osafune/ulexite/pcb/ulexite_parts_v1.0.pdf

ページ 1

種別 | 型　　番 | 発注品番 | 単価 | 数 | 価格 | 備　考
IC | FAN5333BSX | FAN5333BSXCT-ND | Digi-key (http://search.digikey.jp/scripts/DkSearch/dksus.dll?Detail?name=FAN5333BSXCT-ND) | 77.72 | 1 | 77.72 | 25pcs
| BU9480F-E2 | BU9480F-E2CT-ND | Digi-key (http://search.digikey.jp/scripts/DkSearch/dksus.dll?Detail?name=BU9480F-E2CT-ND) | 321.44 | 1 | 321.44 | 25pcs
D | BAT54-7-F | BAT54-FDICT-ND | Digi-key (http://search.digikey.jp/scripts/DkSearch/dksus.dll?Detail?name=BAT54-FDICT-ND) | 13.96 | 1 | 13.96 | 25pcs
RM | CRA06S0834K70JTA | CRA6S84.7KCT-ND | Digi-key (http://search.digikey.jp/scripts/DkSearch/dksus.dll?Detail?name=CRA6S84.7KCT-ND) | 9.60 | 1 | 9.60 | 10pcs
R | 15Ω (±1%, 1/16W, 1608メトリック) | RMCF0603FT15R0CT-ND | Digi-key (http://search.digikey.jp/scripts/DkSearch/dksus.dll?Detail?name=RMCF0603FT15R0CT-ND) | 2.60 | 1 | 2.60 | 10pcs
| 15kΩ (1/16W, 1608メトリック) | RMCF0603JT15K0CT-ND | Digi-key (http://search.digikey.jp/scripts/DkSearch/dksus.dll?Detail?name=RMCF0603JT15K0CT-ND) | 1.80 | 1 | 1.80 | 10pcs
| 20kΩ (1/16W, 1608メトリック) | RMCF0603JT20K0CT-ND | Digi-key (http://search.digikey.jp/scripts/DkSearch/dksus.dll?Detail?name=RMCF0603JT20K0CT-ND) | 1.80 | 1 | 1.80 | 10pcs
L | 10uH/1.4A (5020メトリック) | 587-2409-1-ND | Digi-key (http://search.digikey.jp/scripts/DkSearch/dksus.dll?Detail?name=587-2409-1-ND) | 37.20 | 1 | 37.20 | 10pcs
C | 0.1uF/50V (Y5V, 1608メトリック) | 311-1343-1-ND | Digi-key (http://search.digikey.jp/scripts/DkSearch/dksus.dll?Detail?name=311-1343-1-ND) | 0.79 | 3 | 2.37 | 100pcs
| 0.47uF/50V (Y5V, 1608メトリック) | 445-7465-1-ND | Digi-key (http://search.digikey.jp/scripts/DkSearch/dksus.dll?Detail?name=445-7465-1-ND) | 12.80 | 1 | 12.80 | 10pcs
| 10uF/10V (Y5V, 2012メトリック) | 311-1355-1-ND | Digi-key (http://search.digikey.jp/scripts/DkSearch/dksus.dll?Detail?name=311-1355-1-ND) | 8.52 | 1 | 8.52 | 25pcs
| 10uF/16V (アルミ電解, φ4) | 338-1794-1-ND | Digi-key (http://search.digikey.jp/scripts/DkSearch/dksus.dll?Detail?name=338-1794-1-ND) | 11.42 | 3 | 34.26 | 10pcs
CON | NPPC051KFXC-RC | S5636-ND | Digi-key (http://search.digikey.jp/scripts/DkSearch/dksus.dll?Detail?name=S5636-ND) | 77.80 | 1 | 77.80 | 25pcs
| NPPC202KFMS-RC | S5729-ND | Digi-key (http://search.digikey.jp/scripts/DkSearch/dksus.dll?Detail?name=S5729-ND) | 325.72 | 1 | 325.72 | 25pcs
| SJ1-3523N | CP1-3523N-ND | Digi-key (http://search.digikey.jp/scripts/DkSearch/dksus.dll?Detail?name=CP1-3523N-ND) | 60.80 | 1 | 60.80 | 10pcs
| XF2M-4015-1A | OR729CT-ND | Digi-key (http://search.digikey.jp/scripts/DkSearch/dksus.dll?Detail?name=OR729CT-ND) | 201.72 | 1 | 201.72 | 25pcs
LCD | ATM0430D5 | P-05285 | 秋月 (http://akizukidenshi.com/catalog/g/gP-05285/) | 3,000.00 | 1 | 3,000.00 | FG040346DSSWBG03で代用可
PCB | ULEXITE PCB | | | 1,890.00 | 1 | 1,890.00 | P板.com、20セット販売時単価
U | ULEXITEアクリルトップ | | | 400.00 | 1 | 400.00 | アクリルパネル加工費含む
| M3X18六角スペーサ | BSB-318CE | | 60.00 | 4 | 240.00
| PPストラックケース２６７６ | P-05475 | 秋月 (http://akizukidenshi.com/catalog/g/gP-05475/) | 90.00 | 1 | 90.00 | 10pcs
| 実装費 | | | 1,050.00 | 1 | 1,050.00 | P板.com、15枚実装時単価
| その他雑費 | | | 1,000.00 | 1 | 1,000.00

以下、余白

計 ￥8,860 | 少数以下切り捨て
税 ￥443 | 消費税５％、少数以下切捨て
合計 ￥9,303
ULEXITE部品価格表 (Rev1.0a) | ※価格は2013年7月4日現在 最新価格については各サイト参照

ページ 2

部品番号 | 数 | 型番または仕様 | 備　考
C1 | 1 | 10uF/10V (積層セラミック, 2012メトリック) | Y5V特性以上
C2,C5,C9 | 3 | 0.1uF/50V (積層セラミック, 1608メトリック) | Y5V特性以上
C3 | 1 | 0.47uF/50V (積層セラミック, 1608メトリック) | Y5V特性以上
C4,C6-8 | 3 | 10uF/16V (アルミ電解, φ4) | C4は未実装
CN1 | 1 | NPPC202KFMS
CN2 | 1 | NPPC051KFXC | NPPC051KFXDでも可
CN3 | 1 | SJ1-3523N
CN4 | 1 | XF2M-4015-1A | ハンダ面実装
D1 | 1 | BAT54-7-F
IC1 | 1 | FAN5333BSX
IC2 | 1 | BU9480F
L1 | 1 | 10uH/1.4A (5020メトリック)
R1 | 1 | 15kΩ (±5%, 1/16W, 1608メトリック)
R2 | 1 | 20kΩ (±5%, 1/16W, 1608メトリック)
R3 | 1 | 15Ω (±1%, 1/16W, 1608メトリック)
RM1 | 1 | 4.7kΩ (±5%, 1/16W, 独立4連, 3216凸端子)

以下余白

ULEXITE実装部品表 | 2013年7月4日 Rev1.0a
