osafune/ulexite/pcb/ulexite_panel.dxf

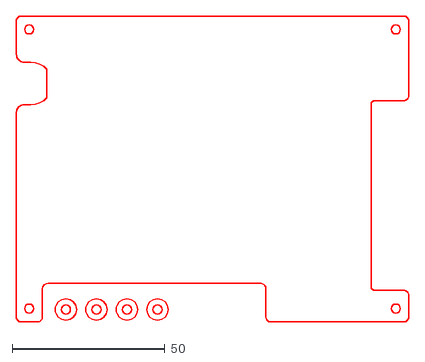
[picture p3: CAD file, 2013-12-19]
pcb/ulexite_panel.dxf
128.4 x 100.1
