osafune/ulexite/pcb/ulexite_pcb_v1.0.pdf

L

C

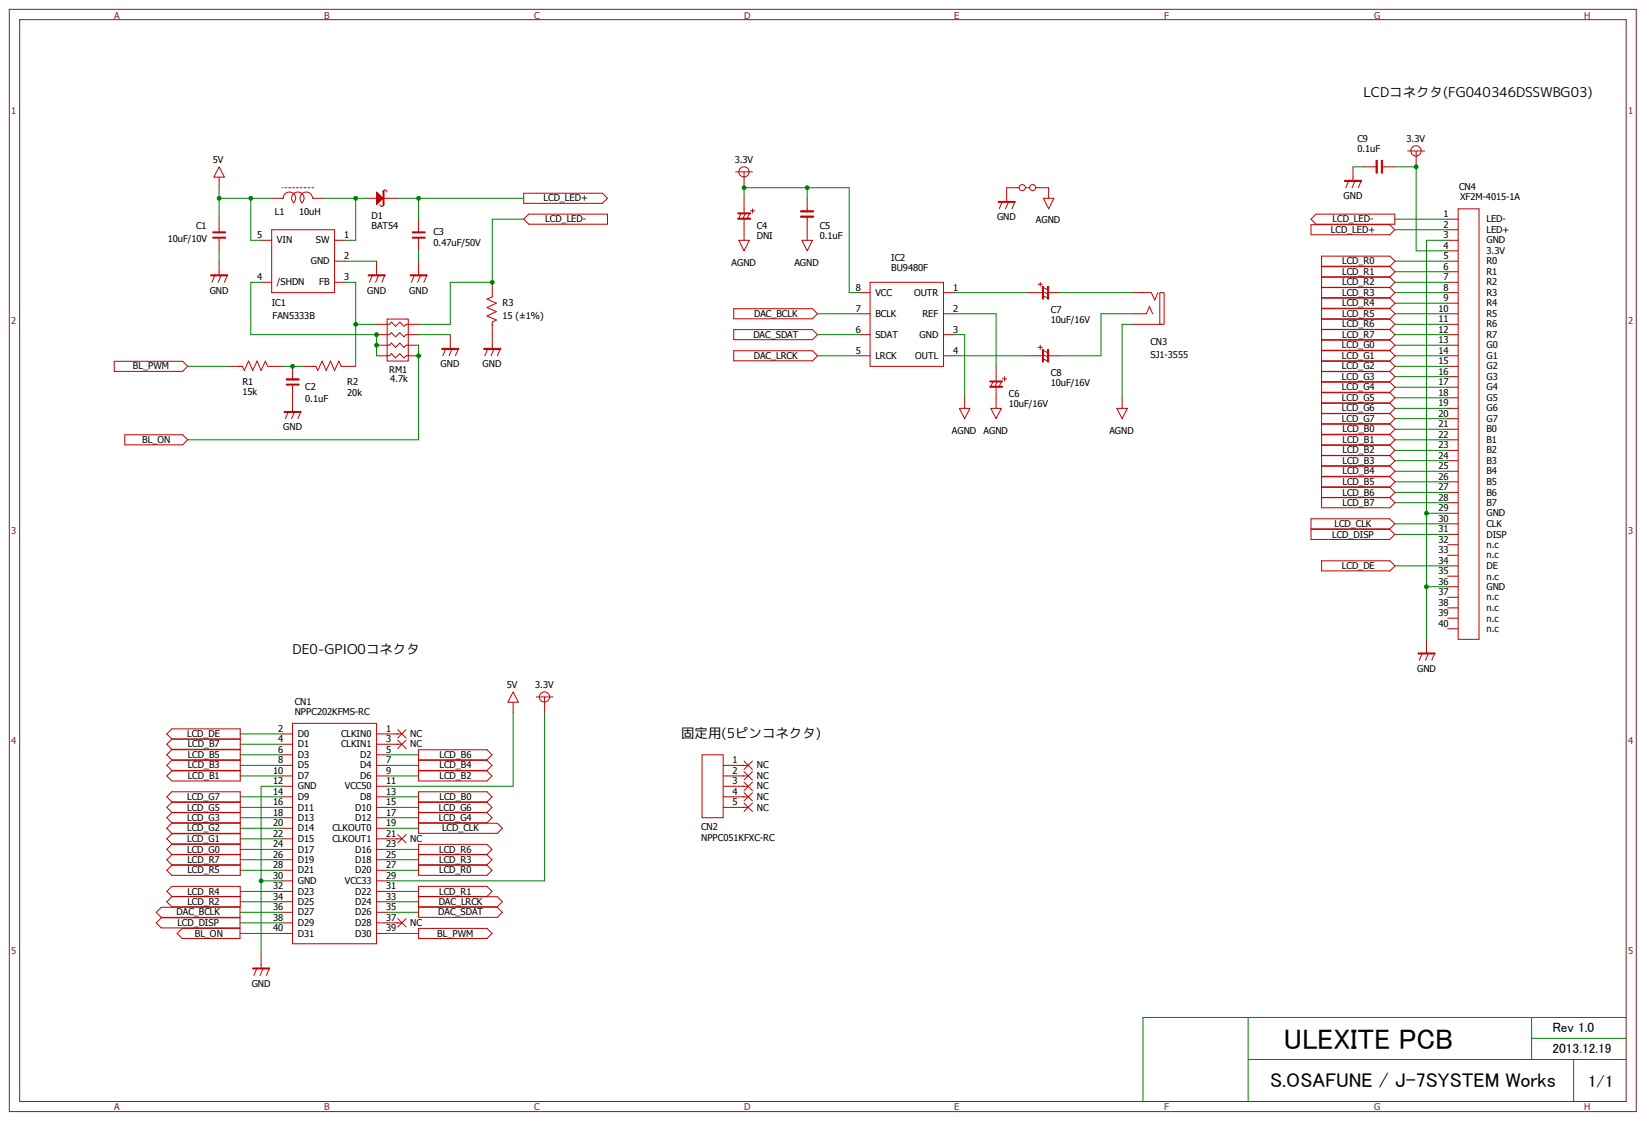
[picture p6: page 1]
PIO

L C D _ G 3 | 1 6
L C D _ G 4 | 1 8
L C D _ G 5 | 1 9
L C D _ G 7 | 2 0
L C D _ B 0 | 2 2

L C D _ B 1 | 2 3
L C D _ B 3 | 2 4
L C D _ B 4 | 2 6
L C D _ B 5 | 2 7
L C D _ B 7 | 2 8

1 6 | 1 5
1 8 | 1 7
2 0 | 1 9
2 2 | N | L C D _ C L K

2 4
2 6 | 2 5
2 8 | 2 7
3 0 | 2 9
3 2 | 3 1 L C D _ R 1
3 4 | 3 3
3 6 | 3 5 | D A C_ L R C K
3 8 | N | D A C_ S D AT
4 0
