osafune/ulexite/(list of files, drawings)

Other design files:
pcb/ulexite_pcb.pcb
