osafune/ulexite/de0_sample/cineraria_ulexite/cineraria_core/synthesis/submodules/fpoint_hw_qsys.v

// Copyright (C) 1991-2010 Altera Corporation
//  Your use of Altera Corporation's design tools, logic functions 
//  and other software and tools, and its AMPP partner logic 
//  functions, and any output files from any of the foregoing 
//  (including device programming or simulation files), and any 
//  associated documentation or information are expressly subject 
//  to the terms and conditions of the Altera Program License 
//  Subscription Agreement, Altera MegaCore Function License 
//  Agreement, or other applicable license agreement, including, 
//  without limitation, that your use is for the sole purpose of 
//  programming logic devices manufactured by Altera and sold by 
//  Altera or its authorized distributors.  Please refer to the 
//  applicable agreement for further details.



//synthesis_resources = lpm_add_sub 4 lpm_mult 1 reg 254 
//synopsys translate_off
`timescale 1 ps / 1 ps
//synopsys translate_on
module  fpoint_hw_qsys_mult_single
	( 
	aclr,
	clk_en,
	clock,
	dataa,
	datab,
	result) /* synthesis synthesis_clearbox=1 */;
	input   aclr;
	input   clk_en;
	input   clock;
	input   [31:0]  dataa;
	input   [31:0]  datab;
	output   [31:0]  result;
`ifndef ALTERA_RESERVED_QIS
// synopsys translate_off
`endif
	tri0   aclr;
	tri1   clk_en;
`ifndef ALTERA_RESERVED_QIS
// synopsys translate_on
`endif

	reg	dataa_exp_all_one_ff_p1;
	reg	dataa_exp_not_zero_ff_p1;
	reg	dataa_man_not_zero_ff_p1;
	reg	dataa_man_not_zero_ff_p2;
	reg	datab_exp_all_one_ff_p1;
	reg	datab_exp_not_zero_ff_p1;
	reg	datab_man_not_zero_ff_p1;
	reg	datab_man_not_zero_ff_p2;
	reg	[9:0]	delay_exp2_bias;
	reg	[9:0]	delay_exp3_bias;
	reg	[9:0]	delay_exp_bias;
	reg	delay_man_product_msb;
	reg	delay_man_product_msb2;
	reg	delay_man_product_msb_p0;
	reg	[23:0]	delay_round;
	reg	[8:0]	exp_add_p1;
	reg	[9:0]	exp_adj_p1;
	reg	[9:0]	exp_adj_p2;
	reg	[8:0]	exp_bias_p1;
	reg	[8:0]	exp_bias_p2;
	reg	[7:0]	exp_result_ff;
	reg	input_is_infinity_dffe_0;
	reg	input_is_infinity_dffe_1;
	reg	input_is_infinity_dffe_2;
	reg	input_is_infinity_dffe_3;
	reg	input_is_infinity_ff1;
	reg	input_is_infinity_ff2;
	reg	input_is_infinity_ff3;
	reg	input_is_infinity_ff4;
	reg	input_is_nan_dffe_0;
	reg	input_is_nan_dffe_1;
	reg	input_is_nan_dffe_2;
	reg	input_is_nan_dffe_3;
	reg	input_is_nan_ff1;
	reg	input_is_nan_ff2;
	reg	input_is_nan_ff3;
	reg	input_is_nan_ff4;
	reg	input_not_zero_dffe_0;
	reg	input_not_zero_dffe_1;
	reg	input_not_zero_dffe_2;
	reg	input_not_zero_dffe_3;
	reg	input_not_zero_ff1;
	reg	input_not_zero_ff2;
	reg	input_not_zero_ff3;
	reg	input_not_zero_ff4;
	reg	lsb_dffe;
	reg	[22:0]	man_result_ff;
	reg	man_round_carry_p0;
	reg	[23:0]	man_round_p;
	reg	[23:0]	man_round_p0;
	reg	[24:0]	man_round_p2;
	reg	round_dffe;
	reg	[0:0]	sign_node_ff0;
	reg	[0:0]	sign_node_ff1;
	reg	[0:0]	sign_node_ff2;
	reg	[0:0]	sign_node_ff3;
	reg	[0:0]	sign_node_ff4;
	reg	[0:0]	sign_node_ff5;
	reg	[0:0]	sign_node_ff6;
	reg	[0:0]	sign_node_ff7;
	reg	[0:0]	sign_node_ff8;
	reg	[0:0]	sign_node_ff9;
	reg	sticky_dffe;
	wire  [8:0]   wire_exp_add_adder_result;
	wire  [9:0]   wire_exp_adj_adder_result;
	wire  [9:0]   wire_exp_bias_subtr_result;
	wire  [24:0]   wire_man_round_adder_result;
	wire  [47:0]   wire_man_product2_mult_result;
	wire  [9:0]  bias;
	wire  [7:0]  dataa_exp_all_one;
	wire  [7:0]  dataa_exp_not_zero;
	wire  [22:0]  dataa_man_not_zero;
	wire  [7:0]  datab_exp_all_one;
	wire  [7:0]  datab_exp_not_zero;
	wire  [22:0]  datab_man_not_zero;
	wire  exp_is_inf;
	wire  exp_is_zero;
	wire  [9:0]  expmod;
	wire  [7:0]  inf_num;
	wire  lsb_bit;
	wire  [24:0]  man_shift_full;
	wire  [7:0]  result_exp_all_one;
	wire  [8:0]  result_exp_not_zero;
	wire  round_bit;
	wire  round_carry;
	wire  [22:0]  sticky_bit;

	// synopsys translate_off
	initial
		dataa_exp_all_one_ff_p1 = 0;
	// synopsys translate_on
	always @ ( posedge clock or  posedge aclr)
		if (aclr == 1'b1) dataa_exp_all_one_ff_p1 <= 1'b0;
		else if  (clk_en == 1'b1)   dataa_exp_all_one_ff_p1 <= dataa_exp_all_one[7];
	// synopsys translate_off
	initial
		dataa_exp_not_zero_ff_p1 = 0;
	// synopsys translate_on
	always @ ( posedge clock or  posedge aclr)
		if (aclr == 1'b1) dataa_exp_not_zero_ff_p1 <= 1'b0;
		else if  (clk_en == 1'b1)   dataa_exp_not_zero_ff_p1 <= dataa_exp_not_zero[7];
	// synopsys translate_off
	initial
		dataa_man_not_zero_ff_p1 = 0;
	// synopsys translate_on
	always @ ( posedge clock or  posedge aclr)
		if (aclr == 1'b1) dataa_man_not_zero_ff_p1 <= 1'b0;
		else if  (clk_en == 1'b1)   dataa_man_not_zero_ff_p1 <= dataa_man_not_zero[10];
	// synopsys translate_off
	initial
		dataa_man_not_zero_ff_p2 = 0;
	// synopsys translate_on
	always @ ( posedge clock or  posedge aclr)
		if (aclr == 1'b1) dataa_man_not_zero_ff_p2 <= 1'b0;
		else if  (clk_en == 1'b1)   dataa_man_not_zero_ff_p2 <= dataa_man_not_zero[22];
	// synopsys translate_off
	initial
		datab_exp_all_one_ff_p1 = 0;
	// synopsys translate_on
	always @ ( posedge clock or  posedge aclr)
		if (aclr == 1'b1) datab_exp_all_one_ff_p1 <= 1'b0;
		else if  (clk_en == 1'b1)   datab_exp_all_one_ff_p1 <= datab_exp_all_one[7];
	// synopsys translate_off
	initial
		datab_exp_not_zero_ff_p1 = 0;
	// synopsys translate_on
	always @ ( posedge clock or  posedge aclr)
		if (aclr == 1'b1) datab_exp_not_zero_ff_p1 <= 1'b0;
		else if  (clk_en == 1'b1)   datab_exp_not_zero_ff_p1 <= datab_exp_not_zero[7];
	// synopsys translate_off
	initial
		datab_man_not_zero_ff_p1 = 0;
	// synopsys translate_on
	always @ ( posedge clock or  posedge aclr)
		if (aclr == 1'b1) datab_man_not_zero_ff_p1 <= 1'b0;
		else if  (clk_en == 1'b1)   datab_man_not_zero_ff_p1 <= datab_man_not_zero[10];
	// synopsys translate_off
	initial
		datab_man_not_zero_ff_p2 = 0;
	// synopsys translate_on
	always @ ( posedge clock or  posedge aclr)
		if (aclr == 1'b1) datab_man_not_zero_ff_p2 <= 1'b0;
		else if  (clk_en == 1'b1)   datab_man_not_zero_ff_p2 <= datab_man_not_zero[22];
	// synopsys translate_off
	initial
		delay_exp2_bias = 0;
	// synopsys translate_on
	always @ ( posedge clock or  posedge aclr)
		if (aclr == 1'b1) delay_exp2_bias <= 10'b0;
		else if  (clk_en == 1'b1)   delay_exp2_bias <= delay_exp_bias;
	// synopsys translate_off
	initial
		delay_exp3_bias = 0;
	// synopsys translate_on
	always @ ( posedge clock or  posedge aclr)
		if (aclr == 1'b1) delay_exp3_bias <= 10'b0;
		else if  (clk_en == 1'b1)   delay_exp3_bias <= delay_exp2_bias;
	// synopsys translate_off
	initial
		delay_exp_bias = 0;
	// synopsys translate_on
	always @ ( posedge clock or  posedge aclr)
		if (aclr == 1'b1) delay_exp_bias <= 10'b0;
		else if  (clk_en == 1'b1)   delay_exp_bias <= wire_exp_bias_subtr_result;
	// synopsys translate_off
	initial
		delay_man_product_msb = 0;
	// synopsys translate_on
	always @ ( posedge clock or  posedge aclr)
		if (aclr == 1'b1) delay_man_product_msb <= 1'b0;
		else if  (clk_en == 1'b1)   delay_man_product_msb <= delay_man_product_msb_p0;
	// synopsys translate_off
	initial
		delay_man_product_msb2 = 0;
	// synopsys translate_on
	always @ ( posedge clock or  posedge aclr)
		if (aclr == 1'b1) delay_man_product_msb2 <= 1'b0;
		else if  (clk_en == 1'b1)   delay_man_product_msb2 <= delay_man_product_msb;
	// synopsys translate_off
	initial
		delay_man_product_msb_p0 = 0;
	// synopsys translate_on
	always @ ( posedge clock or  posedge aclr)
		if (aclr == 1'b1) delay_man_product_msb_p0 <= 1'b0;
		else if  (clk_en == 1'b1)   delay_man_product_msb_p0 <= wire_man_product2_mult_result[47];
	// synopsys translate_off
	initial
		delay_round = 0;
	// synopsys translate_on
	always @ ( posedge clock or  posedge aclr)
		if (aclr == 1'b1) delay_round <= 24'b0;
		else if  (clk_en == 1'b1)   delay_round <= ((man_round_p2[23:0] & {24{(~ man_round_p2[24])}}) | (man_round_p2[24:1] & {24{man_round_p2[24]}}));
	// synopsys translate_off
	initial
		exp_add_p1 = 0;
	// synopsys translate_on
	always @ ( posedge clock or  posedge aclr)
		if (aclr == 1'b1) exp_add_p1 <= 9'b0;
		else if  (clk_en == 1'b1)   exp_add_p1 <= wire_exp_add_adder_result;
	// synopsys translate_off
	initial
		exp_adj_p1 = 0;
	// synopsys translate_on
	always @ ( posedge clock or  posedge aclr)
		if (aclr == 1'b1) exp_adj_p1 <= 10'b0;
		else if  (clk_en == 1'b1)   exp_adj_p1 <= delay_exp3_bias;
	// synopsys translate_off
	initial
		exp_adj_p2 = 0;
	// synopsys translate_on
	always @ ( posedge clock or  posedge aclr)
		if (aclr == 1'b1) exp_adj_p2 <= 10'b0;
		else if  (clk_en == 1'b1)   exp_adj_p2 <= wire_exp_adj_adder_result;
	// synopsys translate_off
	initial
		exp_bias_p1 = 0;
	// synopsys translate_on
	always @ ( posedge clock or  posedge aclr)
		if (aclr == 1'b1) exp_bias_p1 <= 9'b0;
		else if  (clk_en == 1'b1)   exp_bias_p1 <= exp_add_p1[8:0];
	// synopsys translate_off
	initial
		exp_bias_p2 = 0;
	// synopsys translate_on
	always @ ( posedge clock or  posedge aclr)
		if (aclr == 1'b1) exp_bias_p2 <= 9'b0;
		else if  (clk_en == 1'b1)   exp_bias_p2 <= exp_bias_p1;
	// synopsys translate_off
	initial
		exp_result_ff = 0;
	// synopsys translate_on
	always @ ( posedge clock or  posedge aclr)
		if (aclr == 1'b1) exp_result_ff <= 8'b0;
		else if  (clk_en == 1'b1)   exp_result_ff <= ((inf_num & {8{((exp_is_inf | input_is_infinity_ff4) | input_is_nan_ff4)}}) | ((exp_adj_p2[7:0] & {8{(~ exp_is_zero)}}) & {8{input_not_zero_ff4}}));
	// synopsys translate_off
	initial
		input_is_infinity_dffe_0 = 0;
	// synopsys translate_on
	always @ ( posedge clock or  posedge aclr)
		if (aclr == 1'b1) input_is_infinity_dffe_0 <= 1'b0;
		else if  (clk_en == 1'b1)   input_is_infinity_dffe_0 <= ((dataa_exp_all_one_ff_p1 & (~ (dataa_man_not_zero_ff_p1 | dataa_man_not_zero_ff_p2))) | (datab_exp_all_one_ff_p1 & (~ (datab_man_not_zero_ff_p1 | datab_man_not_zero_ff_p2))));
	// synopsys translate_off
	initial
		input_is_infinity_dffe_1 = 0;
	// synopsys translate_on
	always @ ( posedge clock or  posedge aclr)
		if (aclr == 1'b1) input_is_infinity_dffe_1 <= 1'b0;
		else if  (clk_en == 1'b1)   input_is_infinity_dffe_1 <= input_is_infinity_dffe_0;
	// synopsys translate_off
	initial
		input_is_infinity_dffe_2 = 0;
	// synopsys translate_on
	always @ ( posedge clock or  posedge aclr)
		if (aclr == 1'b1) input_is_infinity_dffe_2 <= 1'b0;
		else if  (clk_en == 1'b1)   input_is_infinity_dffe_2 <= input_is_infinity_dffe_1;
	// synopsys translate_off
	initial
		input_is_infinity_dffe_3 = 0;
	// synopsys translate_on
	always @ ( posedge clock or  posedge aclr)
		if (aclr == 1'b1) input_is_infinity_dffe_3 <= 1'b0;
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
		else if  (clk_en == 1'b1)   input_not_zero_dffe_2 <= input_not_zero_dffe_1;
	// synopsys translate_off
	initial
		input_not_zero_dffe_3 = 0;
	// synopsys translate_on
	always @ ( posedge clock or  posedge aclr)
		if (aclr == 1'b1) input_not_zero_dffe_3 <= 1'b0;
		else if  (clk_en == 1'b1)   input_not_zero_dffe_3 <= input_not_zero_dffe_2;
	// synopsys translate_off
	initial
		input_not_zero_ff1 = 0;
	// synopsys translate_on
	always @ ( posedge clock or  posedge aclr)
		if (aclr == 1'b1) input_not_zero_ff1 <= 1'b0;
		else if  (clk_en == 1'b1)   input_not_zero_ff1 <= input_not_zero_dffe_3;
	// synopsys translate_off
	initial
		input_not_zero_ff2 = 0;
	// synopsys translate_on
	always @ ( posedge clock or  posedge aclr)
		if (aclr == 1'b1) input_not_zero_ff2 <= 1'b0;
		else if  (clk_en == 1'b1)   input_not_zero_ff2 <= input_not_zero_ff1;
	// synopsys translate_off
	initial
		input_not_zero_ff3 = 0;
	// synopsys translate_on
	always @ ( posedge clock or  posedge aclr)
		if (aclr == 1'b1) input_not_zero_ff3 <= 1'b0;
		else if  (clk_en == 1'b1)   input_not_zero_ff3 <= input_not_zero_ff2;
	// synopsys translate_off
	initial
		input_not_zero_ff4 = 0;
	// synopsys translate_on
	always @ ( posedge clock or  posedge aclr)
		if (aclr == 1'b1) input_not_zero_ff4 <= 1'b0;
		else if  (clk_en == 1'b1)   input_not_zero_ff4 <= input_not_zero_ff3;
	// synopsys translate_off
	initial
		lsb_dffe = 0;
	// synopsys translate_on
	always @ ( posedge clock or  posedge aclr)
		if (aclr == 1'b1) lsb_dffe <= 1'b0;
		else if  (clk_en == 1'b1)   lsb_dffe <= lsb_bit;
	// synopsys translate_off
	initial
		man_result_ff = 0;
	// synopsys translate_on
	always @ ( posedge clock or  posedge aclr)
		if (aclr == 1'b1) man_result_ff <= 23'b0;
		else if  (clk_en == 1'b1)   man_result_ff <= {((((((delay_round[22] & input_not_zero_ff4) & (~ input_is_infinity_ff4)) & (~ exp_is_inf)) & (~ exp_is_zero)) | (input_is_infinity_ff4 & (~ input_not_zero_ff4))) | input_is_nan_ff4), (((((delay_round[21:0] & {22{input_not_zero_ff4}}) & {22{(~ input_is_infinity_ff4)}}) & {22{(~ exp_is_inf)}}) & {22{(~ exp_is_zero)}}) & {22{(~ input_is_nan_ff4)}})};
	// synopsys translate_off
	initial
		man_round_carry_p0 = 0;
	// synopsys translate_on
	always @ ( posedge clock or  posedge aclr)
		if (aclr == 1'b1) man_round_carry_p0 <= 1'b0;
		else if  (clk_en == 1'b1)   man_round_carry_p0 <= round_carry;
	// synopsys translate_off
	initial
		man_round_p = 0;
	// synopsys translate_on
	always @ ( posedge clock or  posedge aclr)
		if (aclr == 1'b1) man_round_p <= 24'b0;
		else if  (clk_en == 1'b1)   man_round_p <= man_shift_full[24:1];
	// synopsys translate_off
	initial
		man_round_p0 = 0;
	// synopsys translate_on
	always @ ( posedge clock or  posedge aclr)
		if (aclr == 1'b1) man_round_p0 <= 24'b0;
		else if  (clk_en == 1'b1)   man_round_p0 <= man_round_p;
	// synopsys translate_off
	initial
		man_round_p2 = 0;
	// synopsys translate_on
	always @ ( posedge clock or  posedge aclr)
		if (aclr == 1'b1) man_round_p2 <= 25'b0;
		else if  (clk_en == 1'b1)   man_round_p2 <= wire_man_round_adder_result;
	// synopsys translate_off
	initial
		round_dffe = 0;
	// synopsys translate_on
	always @ ( posedge clock or  posedge aclr)
		if (aclr == 1'b1) round_dffe <= 1'b0;
		else if  (clk_en == 1'b1)   round_dffe <= round_bit;
	// synopsys translate_off
	initial
		sign_node_ff0 = 0;
	// synopsys translate_on
	always @ ( posedge clock or  posedge aclr)
		if (aclr == 1'b1) sign_node_ff0 <= 1'b0;
		else if  (clk_en == 1'b1)   sign_node_ff0 <= (dataa[31] ^ datab[31]);
	// synopsys translate_off
	initial
		sign_node_ff1 = 0;
	// synopsys translate_on
	always @ ( posedge clock or  posedge aclr)
		if (aclr == 1'b1) sign_node_ff1 <= 1'b0;
		else if  (clk_en == 1'b1)   sign_node_ff1 <= sign_node_ff0[0:0];
	// synopsys translate_off
	initial
		sign_node_ff2 = 0;
	// synopsys translate_on
	always @ ( posedge clock or  posedge aclr)
		if (aclr == 1'b1) sign_node_ff2 <= 1'b0;
		else if  (clk_en == 1'b1)   sign_node_ff2 <= sign_node_ff1[0:0];
	// synopsys translate_off
	initial
		sign_node_ff3 = 0;
	// synopsys translate_on
	always @ ( posedge clock or  posedge aclr)
		if (aclr == 1'b1) sign_node_ff3 <= 1'b0;
		else if  (clk_en == 1'b1)   sign_node_ff3 <= sign_node_ff2[0:0];
	// synopsys translate_off
	initial
		sign_node_ff4 = 0;
	// synopsys translate_on
	always @ ( posedge clock or  posedge aclr)
		if (aclr == 1'b1) sign_node_ff4 <= 1'b0;
		else if  (clk_en == 1'b1)   sign_node_ff4 <= sign_node_ff3[0:0];
	// synopsys translate_off
	initial
		sign_node_ff5 = 0;
	// synopsys translate_on
	always @ ( posedge clock or  posedge aclr)
		if (aclr == 1'b1) sign_node_ff5 <= 1'b0;
		else if  (clk_en == 1'b1)   sign_node_ff5 <= sign_node_ff4[0:0];
	// synopsys translate_off
	initial
		sign_node_ff6 = 0;
	// synopsys translate_on
	always @ ( posedge clock or  posedge aclr)
		if (aclr == 1'b1) sign_node_ff6 <= 1'b0;
		else if  (clk_en == 1'b1)   sign_node_ff6 <= sign_node_ff5[0:0];
	// synopsys translate_off
	initial
		sign_node_ff7 = 0;
	// synopsys translate_on
	always @ ( posedge clock or  posedge aclr)
		if (aclr == 1'b1) sign_node_ff7 <= 1'b0;
		else if  (clk_en == 1'b1)   sign_node_ff7 <= sign_node_ff6[0:0];
	// synopsys translate_off
	initial
		sign_node_ff8 = 0;
	// synopsys translate_on
	always @ ( posedge clock or  posedge aclr)
		if (aclr == 1'b1) sign_node_ff8 <= 1'b0;
		else if  (clk_en == 1'b1)   sign_node_ff8 <= sign_node_ff7[0:0];
	// synopsys translate_off
	initial
		sign_node_ff9 = 0;
	// synopsys translate_on
	always @ ( posedge clock or  posedge aclr)
		if (aclr == 1'b1) sign_node_ff9 <= 1'b0;
		else if  (clk_en == 1'b1)   sign_node_ff9 <= sign_node_ff8[0:0];
	// synopsys translate_off
	initial
		sticky_dffe = 0;
	// synopsys translate_on
	always @ ( posedge clock or  posedge aclr)
		if (aclr == 1'b1) sticky_dffe <= 1'b0;
		else if  (clk_en == 1'b1)   sticky_dffe <= sticky_bit[22];
	lpm_add_sub   exp_add_adder
	( 
	.aclr(aclr),
	.cin(1'b0),
	.clken(clk_en),
	.clock(clock),
	.cout(),
	.dataa({1'b0, dataa[30:23]}),
	.datab({1'b0, datab[30:23]}),
	.overflow(),
	.result(wire_exp_add_adder_result)
	`ifndef FORMAL_VERIFICATION
	// synopsys translate_off
	`endif
	,
	.add_sub(1'b1)
	`ifndef FORMAL_VERIFICATION
	// synopsys translate_on
	`endif
	);
	defparam
		exp_add_adder.lpm_pipeline = 1,
		exp_add_adder.lpm_width = 9,
		exp_add_adder.lpm_type = "lpm_add_sub";
	lpm_add_sub   exp_adj_adder
	( 
	.cin(1'b0),
	.cout(),
	.dataa(exp_adj_p1),
	.datab({expmod[9:0]}),
	.overflow(),
	.result(wire_exp_adj_adder_result)
	`ifndef FORMAL_VERIFICATION
	// synopsys translate_off
	`endif
	,
	.aclr(1'b0),
	.add_sub(1'b1),
	.clken(1'b1),
	.clock(1'b0)
	`ifndef FORMAL_VERIFICATION
	// synopsys translate_on
	`endif
	);
	defparam
		exp_adj_adder.lpm_pipeline = 0,
		exp_adj_adder.lpm_width = 10,
		exp_adj_adder.lpm_type = "lpm_add_sub";
	lpm_add_sub   exp_bias_subtr
	( 
	.cout(),
	.dataa({1'b0, exp_bias_p2}),
	.datab({bias[9:0]}),
	.overflow(),
	.result(wire_exp_bias_subtr_result)
	`ifndef FORMAL_VERIFICATION
	// synopsys translate_off
	`endif
	,
	.aclr(1'b0),
	.add_sub(1'b1),
	.cin(),
	.clken(1'b1),
	.clock(1'b0)
	`ifndef FORMAL_VERIFICATION
	// synopsys translate_on
	`endif
	);
	defparam
		exp_bias_subtr.lpm_direction = "SUB",
		exp_bias_subtr.lpm_pipeline = 0,
		exp_bias_subtr.lpm_representation = "UNSIGNED",
		exp_bias_subtr.lpm_width = 10,
		exp_bias_subtr.lpm_type = "lpm_add_sub";
	lpm_add_sub   man_round_adder
	( 
	.cout(),
	.dataa({1'b0, man_round_p0}),
	.datab({{24{1'b0}}, man_round_carry_p0}),
	.overflow(),
	.result(wire_man_round_adder_result)
	`ifndef FORMAL_VERIFICATION
	// synopsys translate_off
	`endif
	,
	.aclr(1'b0),
	.add_sub(1'b1),
	.cin(),
	.clken(1'b1),
	.clock(1'b0)
	`ifndef FORMAL_VERIFICATION
	// synopsys translate_on
	`endif
	);
	defparam
		man_round_adder.lpm_pipeline = 0,
		man_round_adder.lpm_width = 25,
		man_round_adder.lpm_type = "lpm_add_sub";
	lpm_mult   man_product2_mult
	( 
	.aclr(aclr),
	.clken(clk_en),
	.clock(clock),
	.dataa({1'b1, dataa[22:0]}),
	.datab({1'b1, datab[22:0]}),
	.result(wire_man_product2_mult_result)
	`ifndef FORMAL_VERIFICATION
	// synopsys translate_off
	`endif
	,
	.sum({1{1'b0}})
	`ifndef FORMAL_VERIFICATION
	// synopsys translate_on
	`endif
	);
	defparam
		man_product2_mult.lpm_pipeline = 5,
		man_product2_mult.lpm_representation = "UNSIGNED",
		man_product2_mult.lpm_widtha = 24,
		man_product2_mult.lpm_widthb = 24,
		man_product2_mult.lpm_widthp = 48,
		man_product2_mult.lpm_widths = 1,
		man_product2_mult.lpm_type = "lpm_mult",
		man_product2_mult.lpm_hint = "DEDICATED_MULTIPLIER_CIRCUITRY=YES";
	assign
		bias = {{3{1'b0}}, {7{1'b1}}},
		dataa_exp_all_one = {(dataa[30] & dataa_exp_all_one[6]), (dataa[29] & dataa_exp_all_one[5]), (dataa[28] & dataa_exp_all_one[4]), (dataa[27] & dataa_exp_all_one[3]), (dataa[26] & dataa_exp_all_one[2]), (dataa[25] & dataa_exp_all_one[1]), (dataa[24] & dataa_exp_all_one[0]), dataa[23]},
		dataa_exp_not_zero = {(dataa[30] | dataa_exp_not_zero[6]), (dataa[29] | dataa_exp_not_zero[5]), (dataa[28] | dataa_exp_not_zero[4]), (dataa[27] | dataa_exp_not_zero[3]), (dataa[26] | dataa_exp_not_zero[2]), (dataa[25] | dataa_exp_not_zero[1]), (dataa[24] | dataa_exp_not_zero[0]), dataa[23]},
		dataa_man_not_zero = {(dataa[22] | dataa_man_not_zero[21]), (dataa[21] | dataa_man_not_zero[20]), (dataa[20] | dataa_man_not_zero[19]), (dataa[19] | dataa_man_not_zero[18]), (dataa[18] | dataa_man_not_zero[17]), (dataa[17] | dataa_man_not_zero[16]), (dataa[16] | dataa_man_not_zero[15]), (dataa[15] | dataa_man_not_zero[14]), (dataa[14] | dataa_man_not_zero[13]), (dataa[13] | dataa_man_not_zero[12]), (dataa[12] | dataa_man_not_zero[11]), dataa[11], (dataa[10] | dataa_man_not_zero[9]), (dataa[9] | dataa_man_not_zero[8]), (dataa[8] | dataa_man_not_zero[7]), (dataa[7] | dataa_man_not_zero[6]), (dataa[6] | dataa_man_not_zero[5]), (dataa[5] | dataa_man_not_zero[4]), (dataa[4] | dataa_man_not_zero[3]), (dataa[3] | dataa_man_not_zero[2]), (dataa[2] | dataa_man_not_zero[1]), (dataa[1] | dataa_man_not_zero[0]), dataa[0]},
		datab_exp_all_one = {(datab[30] & datab_exp_all_one[6]), (datab[29] & datab_exp_all_one[5]), (datab[28] & datab_exp_all_one[4]), (datab[27] & datab_exp_all_one[3]), (datab[26] & datab_exp_all_one[2]), (datab[25] & datab_exp_all_one[1]), (datab[24] & datab_exp_all_one[0]), datab[23]},
		datab_exp_not_zero = {(datab[30] | datab_exp_not_zero[6]), (datab[29] | datab_exp_not_zero[5]), (datab[28] | datab_exp_not_zero[4]), (datab[27] | datab_exp_not_zero[3]), (datab[26] | datab_exp_not_zero[2]), (datab[25] | datab_exp_not_zero[1]), (datab[24] | datab_exp_not_zero[0]), datab[23]},
		datab_man_not_zero = {(datab[22] | datab_man_not_zero[21]), (datab[21] | datab_man_not_zero[20]), (datab[20] | datab_man_not_zero[19]), (datab[19] | datab_man_not_zero[18]), (datab[18] | datab_man_not_zero[17]), (datab[17] | datab_man_not_zero[16]), (datab[16] | datab_man_not_zero[15]), (datab[15] | datab_man_not_zero[14]), (datab[14] | datab_man_not_zero[13]), (datab[13] | datab_man_not_zero[12]), (datab[12] | datab_man_not_zero[11]), datab[11], (datab[10] | datab_man_not_zero[9]), (datab[9] | datab_man_not_zero[8]), (datab[8] | datab_man_not_zero[7]), (datab[7] | datab_man_not_zero[6]), (datab[6] | datab_man_not_zero[5]), (datab[5] | datab_man_not_zero[4]), (datab[4] | datab_man_not_zero[3]), (datab[3] | datab_man_not_zero[2]), (datab[2] | datab_man_not_zero[1]), (datab[1] | datab_man_not_zero[0]), datab[0]},
		exp_is_inf = (((~ exp_adj_p2[9]) & exp_adj_p2[8]) | ((~ exp_adj_p2[8]) & result_exp_all_one[7])),
		exp_is_zero = (exp_adj_p2[9] | (~ result_exp_not_zero[8])),
		expmod = {{8{1'b0}}, (delay_man_product_msb2 & man_round_p2[24]), (delay_man_product_msb2 ^ man_round_p2[24])},
		inf_num = {8{1'b1}},
		lsb_bit = man_shift_full[1],
		man_shift_full = ((wire_man_product2_mult_result[46:22] & {25{(~ wire_man_product2_mult_result[47])}}) | (wire_man_product2_mult_result[47:23] & {25{wire_man_product2_mult_result[47]}})),
		result = {sign_node_ff9[0:0], exp_result_ff[7:0], man_result_ff[22:0]},
		result_exp_all_one = {(result_exp_all_one[6] & exp_adj_p2[7]), (result_exp_all_one[5] & exp_adj_p2[6]), (result_exp_all_one[4] & exp_adj_p2[5]), (result_exp_all_one[3] & exp_adj_p2[4]), (result_exp_all_one[2] & exp_adj_p2[3]), (result_exp_all_one[1] & exp_adj_p2[2]), (result_exp_all_one[0] & exp_adj_p2[1]), exp_adj_p2[0]},
		result_exp_not_zero = {(result_exp_not_zero[7] | exp_adj_p2[8]), (result_exp_not_zero[6] | exp_adj_p2[7]), (result_exp_not_zero[5] | exp_adj_p2[6]), (result_exp_not_zero[4] | exp_adj_p2[5]), (result_exp_not_zero[3] | exp_adj_p2[4]), (result_exp_not_zero[2] | exp_adj_p2[3]), (result_exp_not_zero[1] | exp_adj_p2[2]), (result_exp_not_zero[0] | exp_adj_p2[1]), exp_adj_p2[0]},
		round_bit = man_shift_full[0],
		round_carry = (round_dffe & (lsb_dffe | sticky_dffe)),
		sticky_bit = {(sticky_bit[21] | (wire_man_product2_mult_result[47] & wire_man_product2_mult_result[22])), (sticky_bit[20] | wire_man_product2_mult_result[21]), (sticky_bit[19] | wire_man_product2_mult_result[20]), (sticky_bit[18] | wire_man_product2_mult_result[19]), (sticky_bit[17] | wire_man_product2_mult_result[18]), (sticky_bit[16] | wire_man_product2_mult_result[17]), (sticky_bit[15] | wire_man_product2_mult_result[16]), (sticky_bit[14] | wire_man_product2_mult_result[15]), (sticky_bit[13] | wire_man_product2_mult_result[14]), (sticky_bit[12] | wire_man_product2_mult_result[13]), (sticky_bit[11] | wire_man_product2_mult_result[12]), (sticky_bit[10] | wire_man_product2_mult_result[11]), (sticky_bit[9] | wire_man_product2_mult_result[10]), (sticky_bit[8] | wire_man_product2_mult_result[9]), (sticky_bit[7] | wire_man_product2_mult_result[8]), (sticky_bit[6] | wire_man_product2_mult_result[7]), (sticky_bit[5] | wire_man_product2_mult_result[6]), (sticky_bit[4] | wire_man_product2_mult_result[5]), (sticky_bit[3] | wire_man_product2_mult_result[4]), (sticky_bit[2] | wire_man_product2_mult_result[3]), (sticky_bit[1] | wire_man_product2_mult_result[2]), (sticky_bit[0] | wire_man_product2_mult_result[1]), wire_man_product2_mult_result[0]};
endmodule //fpoint_hw_qsys_mult_single
//VALID FILE

//altfp_add_sub CBX_AUTO_BLACKBOX="ON" CBX_SINGLE_OUTPUT_FILE="ON" DENORMAL_SUPPORT="NO" DEVICE_FAMILY="STRATIXIV" DIRECTION="VARIABLE" EXCEPTION_HANDLING="NO" PIPELINE=8 REDUCED_FUNCTIONALITY="NO" SPEED_OPTIMIZED="YES" WIDTH_EXP=8 WIDTH_MAN=23 aclr add_sub clk_en clock dataa datab result
//VERSION_BEGIN 10.1 cbx_altbarrel_shift 2010:09:06:21:07:24:PN cbx_altfp_add_sub 2010:09:06:21:07:24:PN cbx_altpriority_encoder 2010:09:06:21:07:25:PN cbx_cycloneii 2010:09:06:21:07:25:PN cbx_lpm_add_sub 2010:09:06:21:07:25:PN cbx_lpm_compare 2010:09:06:21:07:25:PN cbx_mgl 2010:09:06:21:22:18:PN cbx_stratix 2010:09:06:21:07:25:PN cbx_stratixii 2010:09:06:21:07:25:PN  VERSION_END
// synthesis VERILOG_INPUT_VERSION VERILOG_2001
// altera message_off 10463



// Copyright (C) 1991-2010 Altera Corporation
//  Your use of Altera Corporation's design tools, logic functions 
//  and other software and tools, and its AMPP partner logic 
//  functions, and any output files from any of the foregoing 
//  (including device programming or simulation files), and any 
//  associated documentation or information are expressly subject 
//  to the terms and conditions of the Altera Program License 
//  Subscription Agreement, Altera MegaCore Function License 
//  Agreement, or other applicable license agreement, including, 
//  without limitation, that your use is for the sole purpose of 
//  programming logic devices manufactured by Altera and sold by 
//  Altera or its authorized distributors.  Please refer to the 
//  applicable agreement for further details.




//altbarrel_shift CBX_AUTO_BLACKBOX="ON" CBX_SINGLE_OUTPUT_FILE="ON" DEVICE_FAMILY="STRATIXIV" PIPELINE=1 SHIFTDIR="LEFT" WIDTH=26 WIDTHDIST=5 aclr clk_en clock data distance result
//VERSION_BEGIN 10.1 cbx_altbarrel_shift 2010:09:06:21:07:24:PN cbx_mgl 2010:09:06:21:22:18:PN  VERSION_END

//synthesis_resources = reg 27 
//synopsys translate_off
`timescale 1 ps / 1 ps
//synopsys translate_on
module  fpoint_hw_qsys_addsub_single_altbarrel_shift_fjg
	( 
	aclr,
	clk_en,
	clock,
	data,
	distance,
	result) /* synthesis synthesis_clearbox=1 */;
	input   aclr;
	input   clk_en;
	input   clock;
	input   [25:0]  data;
	input   [4:0]  distance;
	output   [25:0]  result;
`ifndef ALTERA_RESERVED_QIS
// synopsys translate_off
`endif
	tri0   aclr;
	tri1   clk_en;
	tri0   clock;
`ifndef ALTERA_RESERVED_QIS
// synopsys translate_on
`endif

	reg	[0:0]	dir_pipe;
	reg	[25:0]	sbit_piper1d;
	wire  [5:0]  dir_w;
	wire  direction_w;
	wire  [15:0]  pad_w;
	wire  [155:0]  sbit_w;
	wire  [4:0]  sel_w;
	wire  [129:0]  smux_w;

	// synopsys translate_off
	initial
		dir_pipe = 0;
	// synopsys translate_on
	always @ ( posedge clock or  posedge aclr)
		if (aclr == 1'b1) dir_pipe <= 1'b0;
		else if  (clk_en == 1'b1)   dir_pipe <= {dir_w[4]};
	// synopsys translate_off
	initial
		sbit_piper1d = 0;
	// synopsys translate_on
	always @ ( posedge clock or  posedge aclr)
		if (aclr == 1'b1) sbit_piper1d <= 26'b0;
		else if  (clk_en == 1'b1)   sbit_piper1d <= smux_w[129:104];
	assign
		dir_w = {dir_pipe[0], dir_w[3:0], direction_w},
		direction_w = 1'b0,
		pad_w = {16{1'b0}},
		result = sbit_w[155:130],
		sbit_w = {sbit_piper1d, smux_w[103:0], data},
		sel_w = {distance[4:0]},
		smux_w = {((({26{(sel_w[4] & (~ dir_w[4]))}} & {sbit_w[113:104], pad_w[15:0]}) | ({26{(sel_w[4] & dir_w[4])}} & {pad_w[15:0], sbit_w[129:120]})) | ({26{(~ sel_w[4])}} & sbit_w[129:104])), ((({26{(sel_w[3] & (~ dir_w[3]))}} & {sbit_w[95:78], pad_w[7:0]}) | ({26{(sel_w[3] & dir_w[3])}} & {pad_w[7:0], sbit_w[103:86]})) | ({26{(~ sel_w[3])}} & sbit_w[103:78])), ((({26{(sel_w[2] & (~ dir_w[2]))}} & {sbit_w[73:52], pad_w[3:0]}) | ({26{(sel_w[2] & dir_w[2])}} & {pad_w[3:0], sbit_w[77:56]})) | ({26{(~ sel_w[2])}} & sbit_w[77:52])), ((({26{(sel_w[1] & (~ dir_w[1]))}} & {sbit_w[49:26], pad_w[1:0]}) | ({26{(sel_w[1] & dir_w[1])}} & {pad_w[1:0], sbit_w[51:28]})) | ({26{(~ sel_w[1])}} & sbit_w[51:26])), ((({26{(sel_w[0] & (~ dir_w[0]))}} & {sbit_w[24:0], pad_w[0]}) | ({26{(sel_w[0] & dir_w[0])}} & {pad_w[0], sbit_w[25:1]})) | ({26{(~ sel_w[0])}} & sbit_w[25:0]))};
endmodule //fpoint_hw_qsys_addsub_single_altbarrel_shift_fjg


//altbarrel_shift CBX_AUTO_BLACKBOX="ON" CBX_SINGLE_OUTPUT_FILE="ON" DEVICE_FAMILY="STRATIXIV" SHIFTDIR="RIGHT" WIDTH=26 WIDTHDIST=5 data distance result
//VERSION_BEGIN 10.1 cbx_altbarrel_shift 2010:09:06:21:07:24:PN cbx_mgl 2010:09:06:21:22:18:PN  VERSION_END

//synthesis_resources = 
//synopsys translate_off
`timescale 1 ps / 1 ps
//synopsys translate_on
module  fpoint_hw_qsys_addsub_single_altbarrel_shift_44e
	( 
	data,
	distance,
	result) /* synthesis synthesis_clearbox=1 */;
	input   [25:0]  data;
	input   [4:0]  distance;
	output   [25:0]  result;

	wire  [5:0]  dir_w;
	wire  direction_w;
	wire  [15:0]  pad_w;
	wire  [155:0]  sbit_w;
	wire  [4:0]  sel_w;
	wire  [129:0]  smux_w;

	assign
		dir_w = {dir_w[4:0], direction_w},
		direction_w = 1'b1,
		pad_w = {16{1'b0}},
		result = sbit_w[155:130],
		sbit_w = {smux_w[129:0], data},
		sel_w = {distance[4:0]},
		smux_w = {((({26{(sel_w[4] & (~ dir_w[4]))}} & {sbit_w[113:104], pad_w[15:0]}) | ({26{(sel_w[4] & dir_w[4])}} & {pad_w[15:0], sbit_w[129:120]})) | ({26{(~ sel_w[4])}} & sbit_w[129:104])), ((({26{(sel_w[3] & (~ dir_w[3]))}} & {sbit_w[95:78], pad_w[7:0]}) | ({26{(sel_w[3] & dir_w[3])}} & {pad_w[7:0], sbit_w[103:86]})) | ({26{(~ sel_w[3])}} & sbit_w[103:78])), ((({26{(sel_w[2] & (~ dir_w[2]))}} & {sbit_w[73:52], pad_w[3:0]}) | ({26{(sel_w[2] & dir_w[2])}} & {pad_w[3:0], sbit_w[77:56]})) | ({26{(~ sel_w[2])}} & sbit_w[77:52])), ((({26{(sel_w[1] & (~ dir_w[1]))}} & {sbit_w[49:26], pad_w[1:0]}) | ({26{(sel_w[1] & dir_w[1])}} & {pad_w[1:0], sbit_w[51:28]})) | ({26{(~ sel_w[1])}} & sbit_w[51:26])), ((({26{(sel_w[0] & (~ dir_w[0]))}} & {sbit_w[24:0], pad_w[0]}) | ({26{(sel_w[0] & dir_w[0])}} & {pad_w[0], sbit_w[25:1]})) | ({26{(~ sel_w[0])}} & sbit_w[25:0]))};
endmodule //fpoint_hw_qsys_addsub_single_altbarrel_shift_44e


//altpriority_encoder CBX_AUTO_BLACKBOX="ON" CBX_SINGLE_OUTPUT_FILE="ON" WIDTH=32 WIDTHAD=5 data q
//VERSION_BEGIN 10.1 cbx_altpriority_encoder 2010:09:06:21:07:25:PN cbx_mgl 2010:09:06:21:22:18:PN  VERSION_END


//altpriority_encoder CBX_AUTO_BLACKBOX="ON" CBX_SINGLE_OUTPUT_FILE="ON" LSB_PRIORITY="NO" WIDTH=16 WIDTHAD=4 data q
//VERSION_BEGIN 10.1 cbx_altpriority_encoder 2010:09:06:21:07:25:PN cbx_mgl 2010:09:06:21:22:18:PN  VERSION_END


//altpriority_encoder CBX_AUTO_BLACKBOX="ON" CBX_SINGLE_OUTPUT_FILE="ON" LSB_PRIORITY="NO" WIDTH=8 WIDTHAD=3 data q zero
//VERSION_BEGIN 10.1 cbx_altpriority_encoder 2010:09:06:21:07:25:PN cbx_mgl 2010:09:06:21:22:18:PN  VERSION_END


//altpriority_encoder CBX_AUTO_BLACKBOX="ON" CBX_SINGLE_OUTPUT_FILE="ON" LSB_PRIORITY="NO" WIDTH=4 WIDTHAD=2 data q zero
//VERSION_BEGIN 10.1 cbx_altpriority_encoder 2010:09:06:21:07:25:PN cbx_mgl 2010:09:06:21:22:18:PN  VERSION_END


//altpriority_encoder CBX_AUTO_BLACKBOX="ON" CBX_SINGLE_OUTPUT_FILE="ON" LSB_PRIORITY="NO" WIDTH=2 WIDTHAD=1 data q zero
//VERSION_BEGIN 10.1 cbx_altpriority_encoder 2010:09:06:21:07:25:PN cbx_mgl 2010:09:06:21:22:18:PN  VERSION_END

//synthesis_resources = 
//synopsys translate_off
`timescale 1 ps / 1 ps
//synopsys translate_on
module  fpoint_hw_qsys_addsub_single_altpriority_encoder_i0b
	( 
	data,
	q,
	zero) /* synthesis synthesis_clearbox=1 */;
	input   [1:0]  data;
	output   [0:0]  q;
	output   zero;


	assign
		q = {data[1]},
		zero = (~ (data[0] | data[1]));
endmodule //fpoint_hw_qsys_addsub_single_altpriority_encoder_i0b

//synthesis_resources = 
//synopsys translate_off
`timescale 1 ps / 1 ps
//synopsys translate_on
module  fpoint_hw_qsys_addsub_single_altpriority_encoder_l0b
	( 
	data,
	q,
	zero) /* synthesis synthesis_clearbox=1 */;
	input   [3:0]  data;
	output   [1:0]  q;
	output   zero;

	wire  [0:0]   wire_altpriority_encoder13_q;
	wire  wire_altpriority_encoder13_zero;
	wire  [0:0]   wire_altpriority_encoder14_q;
	wire  wire_altpriority_encoder14_zero;

	fpoint_hw_qsys_addsub_single_altpriority_encoder_i0b   altpriority_encoder13
	( 
	.data(data[1:0]),
	.q(wire_altpriority_encoder13_q),
	.zero(wire_altpriority_encoder13_zero));
	fpoint_hw_qsys_addsub_single_altpriority_encoder_i0b   altpriority_encoder14
	( 
	.data(data[3:2]),
	.q(wire_altpriority_encoder14_q),
	.zero(wire_altpriority_encoder14_zero));
	assign
		q = {(~ wire_altpriority_encoder14_zero), ((wire_altpriority_encoder14_zero & wire_altpriority_encoder13_q) | ((~ wire_altpriority_encoder14_zero) & wire_altpriority_encoder14_q))},
		zero = (wire_altpriority_encoder13_zero & wire_altpriority_encoder14_zero);
endmodule //fpoint_hw_qsys_addsub_single_altpriority_encoder_l0b

//synthesis_resources = 
//synopsys translate_off
`timescale 1 ps / 1 ps
//synopsys translate_on
module  fpoint_hw_qsys_addsub_single_altpriority_encoder_q0b
	( 
	data,
	q,
	zero) /* synthesis synthesis_clearbox=1 */;
	input   [7:0]  data;
	output   [2:0]  q;
	output   zero;

	wire  [1:0]   wire_altpriority_encoder11_q;
	wire  wire_altpriority_encoder11_zero;
	wire  [1:0]   wire_altpriority_encoder12_q;
	wire  wire_altpriority_encoder12_zero;

	fpoint_hw_qsys_addsub_single_altpriority_encoder_l0b   altpriority_encoder11
	( 
	.data(data[3:0]),
	.q(wire_altpriority_encoder11_q),
	.zero(wire_altpriority_encoder11_zero));
	fpoint_hw_qsys_addsub_single_altpriority_encoder_l0b   altpriority_encoder12
	( 
	.data(data[7:4]),
	.q(wire_altpriority_encoder12_q),
	.zero(wire_altpriority_encoder12_zero));
	assign
		q = {(~ wire_altpriority_encoder12_zero), (({2{wire_altpriority_encoder12_zero}} & wire_altpriority_encoder11_q) | ({2{(~ wire_altpriority_encoder12_zero)}} & wire_altpriority_encoder12_q))},
		zero = (wire_altpriority_encoder11_zero & wire_altpriority_encoder12_zero);
endmodule //fpoint_hw_qsys_addsub_single_altpriority_encoder_q0b


//altpriority_encoder CBX_AUTO_BLACKBOX="ON" CBX_SINGLE_OUTPUT_FILE="ON" LSB_PRIORITY="NO" WIDTH=8 WIDTHAD=3 data q
//VERSION_BEGIN 10.1 cbx_altpriority_encoder 2010:09:06:21:07:25:PN cbx_mgl 2010:09:06:21:22:18:PN  VERSION_END


//altpriority_encoder CBX_AUTO_BLACKBOX="ON" CBX_SINGLE_OUTPUT_FILE="ON" LSB_PRIORITY="NO" WIDTH=4 WIDTHAD=2 data q
//VERSION_BEGIN 10.1 cbx_altpriority_encoder 2010:09:06:21:07:25:PN cbx_mgl 2010:09:06:21:22:18:PN  VERSION_END


//altpriority_encoder CBX_AUTO_BLACKBOX="ON" CBX_SINGLE_OUTPUT_FILE="ON" LSB_PRIORITY="NO" WIDTH=2 WIDTHAD=1 data q
//VERSION_BEGIN 10.1 cbx_altpriority_encoder 2010:09:06:21:07:25:PN cbx_mgl 2010:09:06:21:22:18:PN  VERSION_END

//synthesis_resources = 
//synopsys translate_off
`timescale 1 ps / 1 ps
//synopsys translate_on
module  fpoint_hw_qsys_addsub_single_altpriority_encoder_iha
	( 
	data,
	q) /* synthesis synthesis_clearbox=1 */;
	input   [1:0]  data;
	output   [0:0]  q;


	assign
		q = {data[1]};
endmodule //fpoint_hw_qsys_addsub_single_altpriority_encoder_iha

//synthesis_resources = 
//synopsys translate_off
`timescale 1 ps / 1 ps
//synopsys translate_on
module  fpoint_hw_qsys_addsub_single_altpriority_encoder_lha
	( 
	data,
	q) /* synthesis synthesis_clearbox=1 */;
	input   [3:0]  data;
	output   [1:0]  q;

	wire  [0:0]   wire_altpriority_encoder17_q;
	wire  [0:0]   wire_altpriority_encoder18_q;
	wire  wire_altpriority_encoder18_zero;

	fpoint_hw_qsys_addsub_single_altpriority_encoder_iha   altpriority_encoder17
	( 
	.data(data[1:0]),
	.q(wire_altpriority_encoder17_q));
	fpoint_hw_qsys_addsub_single_altpriority_encoder_i0b   altpriority_encoder18
	( 
	.data(data[3:2]),
	.q(wire_altpriority_encoder18_q),
	.zero(wire_altpriority_encoder18_zero));
	assign
		q = {(~ wire_altpriority_encoder18_zero), ((wire_altpriority_encoder18_zero & wire_altpriority_encoder17_q) | ((~ wire_altpriority_encoder18_zero) & wire_altpriority_encoder18_q))};
endmodule //fpoint_hw_qsys_addsub_single_altpriority_encoder_lha

//synthesis_resources = 
//synopsys translate_off
`timescale 1 ps / 1 ps
//synopsys translate_on
module  fpoint_hw_qsys_addsub_single_altpriority_encoder_qha
	( 
	data,
	q) /* synthesis synthesis_clearbox=1 */;
	input   [7:0]  data;
	output   [2:0]  q;

	wire  [1:0]   wire_altpriority_encoder15_q;
	wire  [1:0]   wire_altpriority_encoder16_q;
	wire  wire_altpriority_encoder16_zero;

	fpoint_hw_qsys_addsub_single_altpriority_encoder_lha   altpriority_encoder15
	( 
	.data(data[3:0]),
	.q(wire_altpriority_encoder15_q));
	fpoint_hw_qsys_addsub_single_altpriority_encoder_l0b   altpriority_encoder16
	( 
	.data(data[7:4]),
	.q(wire_altpriority_encoder16_q),
	.zero(wire_altpriority_encoder16_zero));
	assign
		q = {(~ wire_altpriority_encoder16_zero), (({2{wire_altpriority_encoder16_zero}} & wire_altpriority_encoder15_q) | ({2{(~ wire_altpriority_encoder16_zero)}} & wire_altpriority_encoder16_q))};
endmodule //fpoint_hw_qsys_addsub_single_altpriority_encoder_qha

//synthesis_resources = 
//synopsys translate_off
`timescale 1 ps / 1 ps
//synopsys translate_on
module  fpoint_hw_qsys_addsub_single_altpriority_encoder_aja
	( 
	data,
	q) /* synthesis synthesis_clearbox=1 */;
	input   [15:0]  data;
	output   [3:0]  q;

	wire  [2:0]   wire_altpriority_encoder10_q;
	wire  wire_altpriority_encoder10_zero;
	wire  [2:0]   wire_altpriority_encoder9_q;

	fpoint_hw_qsys_addsub_single_altpriority_encoder_q0b   altpriority_encoder10
	( 
	.data(data[15:8]),
	.q(wire_altpriority_encoder10_q),
	.zero(wire_altpriority_encoder10_zero));
	fpoint_hw_qsys_addsub_single_altpriority_encoder_qha   altpriority_encoder9
	( 
	.data(data[7:0]),
	.q(wire_altpriority_encoder9_q));
	assign
		q = {(~ wire_altpriority_encoder10_zero), (({3{wire_altpriority_encoder10_zero}} & wire_altpriority_encoder9_q) | ({3{(~ wire_altpriority_encoder10_zero)}} & wire_altpriority_encoder10_q))};
endmodule //fpoint_hw_qsys_addsub_single_altpriority_encoder_aja


//altpriority_encoder CBX_AUTO_BLACKBOX="ON" CBX_SINGLE_OUTPUT_FILE="ON" LSB_PRIORITY="NO" WIDTH=16 WIDTHAD=4 data q zero
//VERSION_BEGIN 10.1 cbx_altpriority_encoder 2010:09:06:21:07:25:PN cbx_mgl 2010:09:06:21:22:18:PN  VERSION_END

//synthesis_resources = 
//synopsys translate_off
`timescale 1 ps / 1 ps
//synopsys translate_on
module  fpoint_hw_qsys_addsub_single_altpriority_encoder_a2b
	( 
	data,
	q,
	zero) /* synthesis synthesis_clearbox=1 */;
	input   [15:0]  data;
	output   [3:0]  q;
	output   zero;

	wire  [2:0]   wire_altpriority_encoder19_q;
	wire  wire_altpriority_encoder19_zero;
	wire  [2:0]   wire_altpriority_encoder20_q;
	wire  wire_altpriority_encoder20_zero;

	fpoint_hw_qsys_addsub_single_altpriority_encoder_q0b   altpriority_encoder19
	( 
	.data(data[7:0]),
	.q(wire_altpriority_encoder19_q),
	.zero(wire_altpriority_encoder19_zero));
	fpoint_hw_qsys_addsub_single_altpriority_encoder_q0b   altpriority_encoder20
	( 
	.data(data[15:8]),
	.q(wire_altpriority_encoder20_q),
	.zero(wire_altpriority_encoder20_zero));
	assign
		q = {(~ wire_altpriority_encoder20_zero), (({3{wire_altpriority_encoder20_zero}} & wire_altpriority_encoder19_q) | ({3{(~ wire_altpriority_encoder20_zero)}} & wire_altpriority_encoder20_q))},
		zero = (wire_altpriority_encoder19_zero & wire_altpriority_encoder20_zero);
endmodule //fpoint_hw_qsys_addsub_single_altpriority_encoder_a2b

//synthesis_resources = 
//synopsys translate_off
`timescale 1 ps / 1 ps
//synopsys translate_on
module  fpoint_hw_qsys_addsub_single_altpriority_encoder_9u8
	( 
	data,
	q) /* synthesis synthesis_clearbox=1 */;
	input   [31:0]  data;
	output   [4:0]  q;

	wire  [3:0]   wire_altpriority_encoder7_q;
	wire  [3:0]   wire_altpriority_encoder8_q;
	wire  wire_altpriority_encoder8_zero;

	fpoint_hw_qsys_addsub_single_altpriority_encoder_aja   altpriority_encoder7
	( 
	.data(data[15:0]),
	.q(wire_altpriority_encoder7_q));
	fpoint_hw_qsys_addsub_single_altpriority_encoder_a2b   altpriority_encoder8
	( 
	.data(data[31:16]),
	.q(wire_altpriority_encoder8_q),
	.zero(wire_altpriority_encoder8_zero));
	assign
		q = {(~ wire_altpriority_encoder8_zero), (({4{wire_altpriority_encoder8_zero}} & wire_altpriority_encoder7_q) | ({4{(~ wire_altpriority_encoder8_zero)}} & wire_altpriority_encoder8_q))};
endmodule //fpoint_hw_qsys_addsub_single_altpriority_encoder_9u8


//altpriority_encoder CBX_AUTO_BLACKBOX="ON" CBX_SINGLE_OUTPUT_FILE="ON" LSB_PRIORITY="YES" WIDTH=32 WIDTHAD=5 data q
//VERSION_BEGIN 10.1 cbx_altpriority_encoder 2010:09:06:21:07:25:PN cbx_mgl 2010:09:06:21:22:18:PN  VERSION_END


//altpriority_encoder CBX_AUTO_BLACKBOX="ON" CBX_SINGLE_OUTPUT_FILE="ON" LSB_PRIORITY="YES" WIDTH=16 WIDTHAD=4 data q zero
//VERSION_BEGIN 10.1 cbx_altpriority_encoder 2010:09:06:21:07:25:PN cbx_mgl 2010:09:06:21:22:18:PN  VERSION_END


//altpriority_encoder CBX_AUTO_BLACKBOX="ON" CBX_SINGLE_OUTPUT_FILE="ON" LSB_PRIORITY="YES" WIDTH=8 WIDTHAD=3 data q zero
//VERSION_BEGIN 10.1 cbx_altpriority_encoder 2010:09:06:21:07:25:PN cbx_mgl 2010:09:06:21:22:18:PN  VERSION_END


//altpriority_encoder CBX_AUTO_BLACKBOX="ON" CBX_SINGLE_OUTPUT_FILE="ON" LSB_PRIORITY="YES" WIDTH=4 WIDTHAD=2 data q zero
//VERSION_BEGIN 10.1 cbx_altpriority_encoder 2010:09:06:21:07:25:PN cbx_mgl 2010:09:06:21:22:18:PN  VERSION_END


//altpriority_encoder CBX_AUTO_BLACKBOX="ON" CBX_SINGLE_OUTPUT_FILE="ON" LSB_PRIORITY="YES" WIDTH=2 WIDTHAD=1 data q zero
//VERSION_BEGIN 10.1 cbx_altpriority_encoder 2010:09:06:21:07:25:PN cbx_mgl 2010:09:06:21:22:18:PN  VERSION_END

//synthesis_resources = 
//synopsys translate_off
`timescale 1 ps / 1 ps
//synopsys translate_on
module  fpoint_hw_qsys_addsub_single_altpriority_encoder_64b
	( 
	data,
	q,
	zero) /* synthesis synthesis_clearbox=1 */;
	input   [1:0]  data;
	output   [0:0]  q;
	output   zero;


	assign
		q = {(~ data[0])},
		zero = (~ (data[0] | data[1]));
endmodule //fpoint_hw_qsys_addsub_single_altpriority_encoder_64b

//synthesis_resources = 
//synopsys translate_off
`timescale 1 ps / 1 ps
//synopsys translate_on
module  fpoint_hw_qsys_addsub_single_altpriority_encoder_94b
	( 
	data,
	q,
	zero) /* synthesis synthesis_clearbox=1 */;
	input   [3:0]  data;
	output   [1:0]  q;
	output   zero;

	wire  [0:0]   wire_altpriority_encoder27_q;
	wire  wire_altpriority_encoder27_zero;
	wire  [0:0]   wire_altpriority_encoder28_q;
	wire  wire_altpriority_encoder28_zero;

	fpoint_hw_qsys_addsub_single_altpriority_encoder_64b   altpriority_encoder27
	( 
	.data(data[1:0]),
	.q(wire_altpriority_encoder27_q),
	.zero(wire_altpriority_encoder27_zero));
	fpoint_hw_qsys_addsub_single_altpriority_encoder_64b   altpriority_encoder28
	( 
	.data(data[3:2]),
	.q(wire_altpriority_encoder28_q),
	.zero(wire_altpriority_encoder28_zero));
	assign
		q = {wire_altpriority_encoder27_zero, ((wire_altpriority_encoder27_zero & wire_altpriority_encoder28_q) | ((~ wire_altpriority_encoder27_zero) & wire_altpriority_encoder27_q))},
		zero = (wire_altpriority_encoder27_zero & wire_altpriority_encoder28_zero);
endmodule //fpoint_hw_qsys_addsub_single_altpriority_encoder_94b

//synthesis_resources = 
//synopsys translate_off
`timescale 1 ps / 1 ps
//synopsys translate_on
module  fpoint_hw_qsys_addsub_single_altpriority_encoder_e4b
	( 
	data,
	q,
	zero) /* synthesis synthesis_clearbox=1 */;
	input   [7:0]  data;
	output   [2:0]  q;
	output   zero;

	wire  [1:0]   wire_altpriority_encoder25_q;
	wire  wire_altpriority_encoder25_zero;
	wire  [1:0]   wire_altpriority_encoder26_q;
	wire  wire_altpriority_encoder26_zero;

	fpoint_hw_qsys_addsub_single_altpriority_encoder_94b   altpriority_encoder25
	( 
	.data(data[3:0]),
	.q(wire_altpriority_encoder25_q),
	.zero(wire_altpriority_encoder25_zero));
	fpoint_hw_qsys_addsub_single_altpriority_encoder_94b   altpriority_encoder26
	( 
	.data(data[7:4]),
	.q(wire_altpriority_encoder26_q),
	.zero(wire_altpriority_encoder26_zero));
	assign
		q = {wire_altpriority_encoder25_zero, (({2{wire_altpriority_encoder25_zero}} & wire_altpriority_encoder26_q) | ({2{(~ wire_altpriority_encoder25_zero)}} & wire_altpriority_encoder25_q))},
		zero = (wire_altpriority_encoder25_zero & wire_altpriority_encoder26_zero);
endmodule //fpoint_hw_qsys_addsub_single_altpriority_encoder_e4b

//synthesis_resources = 
//synopsys translate_off
`timescale 1 ps / 1 ps
//synopsys translate_on
module  fpoint_hw_qsys_addsub_single_altpriority_encoder_u5b
	( 
	data,
	q,
	zero) /* synthesis synthesis_clearbox=1 */;
	input   [15:0]  data;
	output   [3:0]  q;
	output   zero;

	wire  [2:0]   wire_altpriority_encoder23_q;
	wire  wire_altpriority_encoder23_zero;
	wire  [2:0]   wire_altpriority_encoder24_q;
	wire  wire_altpriority_encoder24_zero;

	fpoint_hw_qsys_addsub_single_altpriority_encoder_e4b   altpriority_encoder23
	( 
	.data(data[7:0]),
	.q(wire_altpriority_encoder23_q),
	.zero(wire_altpriority_encoder23_zero));
	fpoint_hw_qsys_addsub_single_altpriority_encoder_e4b   altpriority_encoder24
	( 
	.data(data[15:8]),
	.q(wire_altpriority_encoder24_q),
	.zero(wire_altpriority_encoder24_zero));
	assign
		q = {wire_altpriority_encoder23_zero, (({3{wire_altpriority_encoder23_zero}} & wire_altpriority_encoder24_q) | ({3{(~ wire_altpriority_encoder23_zero)}} & wire_altpriority_encoder23_q))},
		zero = (wire_altpriority_encoder23_zero & wire_altpriority_encoder24_zero);
endmodule //fpoint_hw_qsys_addsub_single_altpriority_encoder_u5b


//altpriority_encoder CBX_AUTO_BLACKBOX="ON" CBX_SINGLE_OUTPUT_FILE="ON" LSB_PRIORITY="YES" WIDTH=16 WIDTHAD=4 data q
//VERSION_BEGIN 10.1 cbx_altpriority_encoder 2010:09:06:21:07:25:PN cbx_mgl 2010:09:06:21:22:18:PN  VERSION_END


//altpriority_encoder CBX_AUTO_BLACKBOX="ON" CBX_SINGLE_OUTPUT_FILE="ON" LSB_PRIORITY="YES" WIDTH=8 WIDTHAD=3 data q
//VERSION_BEGIN 10.1 cbx_altpriority_encoder 2010:09:06:21:07:25:PN cbx_mgl 2010:09:06:21:22:18:PN  VERSION_END


//altpriority_encoder CBX_AUTO_BLACKBOX="ON" CBX_SINGLE_OUTPUT_FILE="ON" LSB_PRIORITY="YES" WIDTH=4 WIDTHAD=2 data q
//VERSION_BEGIN 10.1 cbx_altpriority_encoder 2010:09:06:21:07:25:PN cbx_mgl 2010:09:06:21:22:18:PN  VERSION_END


//altpriority_encoder CBX_AUTO_BLACKBOX="ON" CBX_SINGLE_OUTPUT_FILE="ON" LSB_PRIORITY="YES" WIDTH=2 WIDTHAD=1 data q
//VERSION_BEGIN 10.1 cbx_altpriority_encoder 2010:09:06:21:07:25:PN cbx_mgl 2010:09:06:21:22:18:PN  VERSION_END

//synthesis_resources = 
//synopsys translate_off
`timescale 1 ps / 1 ps
//synopsys translate_on
module  fpoint_hw_qsys_addsub_single_altpriority_encoder_6la
	( 
	data,
	q) /* synthesis synthesis_clearbox=1 */;
	input   [1:0]  data;
	output   [0:0]  q;


	assign
		q = {(~ data[0])};
endmodule //fpoint_hw_qsys_addsub_single_altpriority_encoder_6la

//synthesis_resources = 
//synopsys translate_off
`timescale 1 ps / 1 ps
//synopsys translate_on
module  fpoint_hw_qsys_addsub_single_altpriority_encoder_9la
	( 
	data,
	q) /* synthesis synthesis_clearbox=1 */;
	input   [3:0]  data;
	output   [1:0]  q;

	wire  [0:0]   wire_altpriority_encoder33_q;
	wire  wire_altpriority_encoder33_zero;
	wire  [0:0]   wire_altpriority_encoder34_q;

	fpoint_hw_qsys_addsub_single_altpriority_encoder_64b   altpriority_encoder33
	( 
	.data(data[1:0]),
	.q(wire_altpriority_encoder33_q),
	.zero(wire_altpriority_encoder33_zero));
	fpoint_hw_qsys_addsub_single_altpriority_encoder_6la   altpriority_encoder34
	( 
	.data(data[3:2]),
	.q(wire_altpriority_encoder34_q));
	assign
		q = {wire_altpriority_encoder33_zero, ((wire_altpriority_encoder33_zero & wire_altpriority_encoder34_q) | ((~ wire_altpriority_encoder33_zero) & wire_altpriority_encoder33_q))};
endmodule //fpoint_hw_qsys_addsub_single_altpriority_encoder_9la

//synthesis_resources = 
//synopsys translate_off
`timescale 1 ps / 1 ps
//synopsys translate_on
module  fpoint_hw_qsys_addsub_single_altpriority_encoder_ela
	( 
	data,
	q) /* synthesis synthesis_clearbox=1 */;
	input   [7:0]  data;
	output   [2:0]  q;

	wire  [1:0]   wire_altpriority_encoder31_q;
	wire  wire_altpriority_encoder31_zero;
	wire  [1:0]   wire_altpriority_encoder32_q;

	fpoint_hw_qsys_addsub_single_altpriority_encoder_94b   altpriority_encoder31
	( 
	.data(data[3:0]),
	.q(wire_altpriority_encoder31_q),
	.zero(wire_altpriority_encoder31_zero));
	fpoint_hw_qsys_addsub_single_altpriority_encoder_9la   altpriority_encoder32
	( 
	.data(data[7:4]),
	.q(wire_altpriority_encoder32_q));
	assign
		q = {wire_altpriority_encoder31_zero, (({2{wire_altpriority_encoder31_zero}} & wire_altpriority_encoder32_q) | ({2{(~ wire_altpriority_encoder31_zero)}} & wire_altpriority_encoder31_q))};
endmodule //fpoint_hw_qsys_addsub_single_altpriority_encoder_ela

//synthesis_resources = 
//synopsys translate_off
`timescale 1 ps / 1 ps
//synopsys translate_on
module  fpoint_hw_qsys_addsub_single_altpriority_encoder_uma
	( 
	data,
	q) /* synthesis synthesis_clearbox=1 */;
	input   [15:0]  data;
	output   [3:0]  q;

	wire  [2:0]   wire_altpriority_encoder29_q;
	wire  wire_altpriority_encoder29_zero;
	wire  [2:0]   wire_altpriority_encoder30_q;

	fpoint_hw_qsys_addsub_single_altpriority_encoder_e4b   altpriority_encoder29
	( 
	.data(data[7:0]),
	.q(wire_altpriority_encoder29_q),
	.zero(wire_altpriority_encoder29_zero));
	fpoint_hw_qsys_addsub_single_altpriority_encoder_ela   altpriority_encoder30
	( 
	.data(data[15:8]),
	.q(wire_altpriority_encoder30_q));
	assign
		q = {wire_altpriority_encoder29_zero, (({3{wire_altpriority_encoder29_zero}} & wire_altpriority_encoder30_q) | ({3{(~ wire_altpriority_encoder29_zero)}} & wire_altpriority_encoder29_q))};
endmodule //fpoint_hw_qsys_addsub_single_altpriority_encoder_uma

//synthesis_resources = 
//synopsys translate_off
`timescale 1 ps / 1 ps
//synopsys translate_on
module  fpoint_hw_qsys_addsub_single_altpriority_encoder_tma
	( 
	data,
	q) /* synthesis synthesis_clearbox=1 */;
	input   [31:0]  data;
	output   [4:0]  q;

	wire  [3:0]   wire_altpriority_encoder21_q;
	wire  wire_altpriority_encoder21_zero;
	wire  [3:0]   wire_altpriority_encoder22_q;

	fpoint_hw_qsys_addsub_single_altpriority_encoder_u5b   altpriority_encoder21
	( 
	.data(data[15:0]),
	.q(wire_altpriority_encoder21_q),
	.zero(wire_altpriority_encoder21_zero));
	fpoint_hw_qsys_addsub_single_altpriority_encoder_uma   altpriority_encoder22
	( 
	.data(data[31:16]),
	.q(wire_altpriority_encoder22_q));
	assign
		q = {wire_altpriority_encoder21_zero, (({4{wire_altpriority_encoder21_zero}} & wire_altpriority_encoder22_q) | ({4{(~ wire_altpriority_encoder21_zero)}} & wire_altpriority_encoder21_q))};
endmodule //fpoint_hw_qsys_addsub_single_altpriority_encoder_tma

//synthesis_resources = lpm_add_sub 14 lpm_compare 1 reg 356 
//synopsys translate_off
`timescale 1 ps / 1 ps
//synopsys translate_on
module  fpoint_hw_qsys_addsub_single
	( 
	aclr,
	add_sub,
	clk_en,
	clock,
	dataa,
	datab,
	result) /* synthesis synthesis_clearbox=1 */;
	input   aclr;
	input   add_sub;
	input   clk_en;
	input   clock;
	input   [31:0]  dataa;
	input   [31:0]  datab;
	output   [31:0]  result;
`ifndef ALTERA_RESERVED_QIS
// synopsys translate_off
`endif
	tri0   aclr;
	tri1   add_sub;
	tri1   clk_en;
`ifndef ALTERA_RESERVED_QIS
// synopsys translate_on
`endif

	wire  [25:0]   wire_lbarrel_shift_result;
	wire  [25:0]   wire_rbarrel_shift_result;
	wire  [4:0]   wire_leading_zeroes_cnt_q;
	wire  [4:0]   wire_trailing_zeros_cnt_q;
	reg	add_sub_dffe1;
	reg	add_sub_dffe12;
	reg	[8:0]	aligned_dataa_exp_dffe12;
	reg	[23:0]	aligned_dataa_man_dffe12;
	reg	aligned_dataa_sign_dffe12;
	reg	[8:0]	aligned_datab_exp_dffe12;
	reg	[23:0]	aligned_datab_man_dffe12;
	reg	aligned_datab_sign_dffe12;
	reg	both_inputs_are_infinite_dffe1;
	reg	[7:0]	data_exp_dffe1;
	reg	[25:0]	dataa_man_dffe1;
	reg	dataa_sign_dffe1;
	reg	[25:0]	datab_man_dffe1;
	reg	datab_sign_dffe1;
	reg	denormal_res_dffe3;
	reg	denormal_res_dffe4;
	reg	[1:0]	exp_adj_dffe21;
	reg	[7:0]	exp_out_dffe5;
	reg	[7:0]	exp_res_dffe2;
	reg	[7:0]	exp_res_dffe21;
	reg	[7:0]	exp_res_dffe3;
	reg	[7:0]	exp_res_dffe4;
	reg	infinite_output_sign_dffe1;
	reg	infinite_output_sign_dffe2;
	reg	infinite_output_sign_dffe21;
	reg	infinite_output_sign_dffe3;
	reg	infinite_output_sign_dffe31;
	reg	infinite_output_sign_dffe4;
	reg	infinite_res_dffe3;
	reg	infinite_res_dffe4;
	reg	infinity_magnitude_sub_dffe2;
	reg	infinity_magnitude_sub_dffe21;
	reg	infinity_magnitude_sub_dffe3;
	reg	infinity_magnitude_sub_dffe31;
	reg	infinity_magnitude_sub_dffe4;
	reg	input_dataa_infinite_dffe12;
	reg	input_dataa_nan_dffe12;
	reg	input_datab_infinite_dffe12;
	reg	input_datab_nan_dffe12;
	reg	input_is_infinite_dffe1;
	reg	input_is_infinite_dffe2;
	reg	input_is_infinite_dffe21;
	reg	input_is_infinite_dffe3;
	reg	input_is_infinite_dffe31;
	reg	input_is_infinite_dffe4;
	reg	input_is_nan_dffe1;
	reg	input_is_nan_dffe2;
	reg	input_is_nan_dffe21;
	reg	input_is_nan_dffe3;
	reg	input_is_nan_dffe31;
	reg	input_is_nan_dffe4;
	reg	[25:0]	man_add_sub_res_mag_dffe21;
	reg	man_add_sub_res_sign_dffe21;
	reg	[25:0]	man_dffe31;
	reg	[4:0]	man_leading_zeros_dffe31;
	reg	[22:0]	man_out_dffe5;
	reg	[22:0]	man_res_dffe4;
	reg	man_res_is_not_zero_dffe3;
	reg	man_res_is_not_zero_dffe31;
	reg	man_res_is_not_zero_dffe4;
	reg	need_complement_dffe2;
	reg	round_bit_dffe21;
	reg	round_bit_dffe3;
	reg	round_bit_dffe31;
	reg	rounded_res_infinity_dffe4;
	reg	sign_dffe31;
	reg	sign_out_dffe5;
	reg	sign_res_dffe3;
	reg	sign_res_dffe4;
	reg	sticky_bit_dffe1;
	reg	sticky_bit_dffe2;
	reg	sticky_bit_dffe21;
	reg	sticky_bit_dffe3;
	reg	sticky_bit_dffe31;
	reg	zero_man_sign_dffe2;
	reg	zero_man_sign_dffe21;
	wire  [8:0]   wire_add_sub1_result;
	wire  [8:0]   wire_add_sub2_result;
	wire  [5:0]   wire_add_sub3_result;
	wire  [8:0]   wire_add_sub4_result;
	wire  [8:0]   wire_add_sub5_result;
	wire  [8:0]   wire_add_sub6_result;
	wire  wire_man_2comp_res_lower_cout;
	wire  [13:0]   wire_man_2comp_res_lower_result;
	wire  [13:0]   wire_man_2comp_res_upper0_result;
	wire  [13:0]   wire_man_2comp_res_upper1_result;
	wire  wire_man_add_sub_lower_cout;
	wire  [13:0]   wire_man_add_sub_lower_result;
	wire  [13:0]   wire_man_add_sub_upper0_result;
	wire  [13:0]   wire_man_add_sub_upper1_result;
	wire  wire_man_res_rounding_add_sub_lower_cout;
	wire  [12:0]   wire_man_res_rounding_add_sub_lower_result;
	wire  [12:0]   wire_man_res_rounding_add_sub_upper1_result;
	wire  wire_trailing_zeros_limit_comparator_agb;
	wire  add_sub_dffe11_wi;
	wire  add_sub_dffe11_wo;
	wire  add_sub_dffe12_wi;
	wire  add_sub_dffe12_wo;
	wire  add_sub_dffe13_wi;
	wire  add_sub_dffe13_wo;
	wire  add_sub_dffe14_wi;
	wire  add_sub_dffe14_wo;
	wire  add_sub_dffe15_wi;
	wire  add_sub_dffe15_wo;
	wire  add_sub_dffe1_wi;
	wire  add_sub_dffe1_wo;
	wire  add_sub_dffe25_wi;
	wire  add_sub_dffe25_wo;
	wire  add_sub_w2;
	wire  [12:0]  adder_upper_w;
	wire  [8:0]  aligned_dataa_exp_dffe12_wi;
	wire  [8:0]  aligned_dataa_exp_dffe12_wo;
	wire  [8:0]  aligned_dataa_exp_dffe13_wi;
	wire  [8:0]  aligned_dataa_exp_dffe13_wo;
	wire  [8:0]  aligned_dataa_exp_dffe14_wi;
	wire  [8:0]  aligned_dataa_exp_dffe14_wo;
	wire  [8:0]  aligned_dataa_exp_dffe15_wi;
	wire  [8:0]  aligned_dataa_exp_dffe15_wo;
	wire  [8:0]  aligned_dataa_exp_w;
	wire  [23:0]  aligned_dataa_man_dffe12_wi;
	wire  [23:0]  aligned_dataa_man_dffe12_wo;
	wire  [23:0]  aligned_dataa_man_dffe13_wi;
	wire  [23:0]  aligned_dataa_man_dffe13_wo;
	wire  [23:0]  aligned_dataa_man_dffe14_wi;
	wire  [23:0]  aligned_dataa_man_dffe14_wo;
	wire  [25:0]  aligned_dataa_man_dffe15_w;
	wire  [23:0]  aligned_dataa_man_dffe15_wi;
	wire  [23:0]  aligned_dataa_man_dffe15_wo;
	wire  [25:0]  aligned_dataa_man_w;
	wire  aligned_dataa_sign_dffe12_wi;
	wire  aligned_dataa_sign_dffe12_wo;
	wire  aligned_dataa_sign_dffe13_wi;
	wire  aligned_dataa_sign_dffe13_wo;
	wire  aligned_dataa_sign_dffe14_wi;
	wire  aligned_dataa_sign_dffe14_wo;
	wire  aligned_dataa_sign_dffe15_wi;
	wire  aligned_dataa_sign_dffe15_wo;
	wire  aligned_dataa_sign_w;
	wire  [8:0]  aligned_datab_exp_dffe12_wi;
	wire  [8:0]  aligned_datab_exp_dffe12_wo;
	wire  [8:0]  aligned_datab_exp_dffe13_wi;
	wire  [8:0]  aligned_datab_exp_dffe13_wo;
	wire  [8:0]  aligned_datab_exp_dffe14_wi;
	wire  [8:0]  aligned_datab_exp_dffe14_wo;
	wire  [8:0]  aligned_datab_exp_dffe15_wi;
	wire  [8:0]  aligned_datab_exp_dffe15_wo;
	wire  [8:0]  aligned_datab_exp_w;
	wire  [23:0]  aligned_datab_man_dffe12_wi;
	wire  [23:0]  aligned_datab_man_dffe12_wo;
	wire  [23:0]  aligned_datab_man_dffe13_wi;
	wire  [23:0]  aligned_datab_man_dffe13_wo;
	wire  [23:0]  aligned_datab_man_dffe14_wi;
	wire  [23:0]  aligned_datab_man_dffe14_wo;
	wire  [25:0]  aligned_datab_man_dffe15_w;
	wire  [23:0]  aligned_datab_man_dffe15_wi;
	wire  [23:0]  aligned_datab_man_dffe15_wo;
	wire  [25:0]  aligned_datab_man_w;
	wire  aligned_datab_sign_dffe12_wi;
	wire  aligned_datab_sign_dffe12_wo;
	wire  aligned_datab_sign_dffe13_wi;
	wire  aligned_datab_sign_dffe13_wo;
	wire  aligned_datab_sign_dffe14_wi;
	wire  aligned_datab_sign_dffe14_wo;
	wire  aligned_datab_sign_dffe15_wi;
	wire  aligned_datab_sign_dffe15_wo;
	wire  aligned_datab_sign_w;
	wire  borrow_w;
	wire  both_inputs_are_infinite_dffe1_wi;
	wire  both_inputs_are_infinite_dffe1_wo;
	wire  both_inputs_are_infinite_dffe25_wi;
	wire  both_inputs_are_infinite_dffe25_wo;
	wire  [7:0]  data_exp_dffe1_wi;
	wire  [7:0]  data_exp_dffe1_wo;
	wire  [31:0]  dataa_dffe11_wi;
	wire  [31:0]  dataa_dffe11_wo;
	wire  [25:0]  dataa_man_dffe1_wi;
	wire  [25:0]  dataa_man_dffe1_wo;
	wire  dataa_sign_dffe1_wi;
	wire  dataa_sign_dffe1_wo;
	wire  dataa_sign_dffe25_wi;
	wire  dataa_sign_dffe25_wo;
	wire  [31:0]  datab_dffe11_wi;
	wire  [31:0]  datab_dffe11_wo;
	wire  [25:0]  datab_man_dffe1_wi;
	wire  [25:0]  datab_man_dffe1_wo;
	wire  datab_sign_dffe1_wi;
	wire  datab_sign_dffe1_wo;
	wire  denormal_flag_w;
	wire  denormal_res_dffe32_wi;
	wire  denormal_res_dffe32_wo;
	wire  denormal_res_dffe33_wi;
	wire  denormal_res_dffe33_wo;
	wire  denormal_res_dffe3_wi;
	wire  denormal_res_dffe3_wo;
	wire  denormal_res_dffe41_wi;
	wire  denormal_res_dffe41_wo;
	wire  denormal_res_dffe42_wi;
	wire  denormal_res_dffe42_wo;
	wire  denormal_res_dffe4_wi;
	wire  denormal_res_dffe4_wo;
	wire  denormal_result_w;
	wire  [7:0]  exp_a_all_one_w;
	wire  [7:0]  exp_a_not_zero_w;
	wire  [6:0]  exp_adj_0pads;
	wire  [1:0]  exp_adj_dffe21_wi;
	wire  [1:0]  exp_adj_dffe21_wo;
	wire  [1:0]  exp_adj_dffe23_wi;
	wire  [1:0]  exp_adj_dffe23_wo;
	wire  [1:0]  exp_adj_dffe26_wi;
	wire  [1:0]  exp_adj_dffe26_wo;
	wire  [1:0]  exp_adjust_by_add1;
	wire  [1:0]  exp_adjust_by_add2;
	wire  [8:0]  exp_adjustment2_add_sub_dataa_w;
	wire  [8:0]  exp_adjustment2_add_sub_datab_w;
	wire  [8:0]  exp_adjustment2_add_sub_w;
	wire  [8:0]  exp_adjustment_add_sub_dataa_w;
	wire  [8:0]  exp_adjustment_add_sub_datab_w;
	wire  [8:0]  exp_adjustment_add_sub_w;
	wire  [7:0]  exp_all_ones_w;
	wire  [7:0]  exp_all_zeros_w;
	wire  exp_amb_mux_dffe13_wi;
	wire  exp_amb_mux_dffe13_wo;
	wire  exp_amb_mux_dffe14_wi;
	wire  exp_amb_mux_dffe14_wo;
	wire  exp_amb_mux_dffe15_wi;
	wire  exp_amb_mux_dffe15_wo;
	wire  exp_amb_mux_w;
	wire  [8:0]  exp_amb_w;
	wire  [7:0]  exp_b_all_one_w;
	wire  [7:0]  exp_b_not_zero_w;
	wire  [8:0]  exp_bma_w;
	wire  [2:0]  exp_diff_abs_exceed_max_w;
	wire  [4:0]  exp_diff_abs_max_w;
	wire  [7:0]  exp_diff_abs_w;
	wire  [7:0]  exp_intermediate_res_dffe41_wi;
	wire  [7:0]  exp_intermediate_res_dffe41_wo;
	wire  [7:0]  exp_intermediate_res_dffe42_wi;
	wire  [7:0]  exp_intermediate_res_dffe42_wo;
	wire  [7:0]  exp_intermediate_res_w;
	wire  [7:0]  exp_out_dffe5_wi;
	wire  [7:0]  exp_out_dffe5_wo;
	wire  [7:0]  exp_res_dffe21_wi;
	wire  [7:0]  exp_res_dffe21_wo;
	wire  [7:0]  exp_res_dffe22_wi;
	wire  [7:0]  exp_res_dffe22_wo;
	wire  [7:0]  exp_res_dffe23_wi;
	wire  [7:0]  exp_res_dffe23_wo;
	wire  [7:0]  exp_res_dffe25_wi;
	wire  [7:0]  exp_res_dffe25_wo;
	wire  [7:0]  exp_res_dffe26_wi;
	wire  [7:0]  exp_res_dffe26_wo;
	wire  [7:0]  exp_res_dffe27_wi;
	wire  [7:0]  exp_res_dffe27_wo;
	wire  [7:0]  exp_res_dffe2_wi;
	wire  [7:0]  exp_res_dffe2_wo;
	wire  [7:0]  exp_res_dffe32_wi;
	wire  [7:0]  exp_res_dffe32_wo;
	wire  [7:0]  exp_res_dffe33_wi;
	wire  [7:0]  exp_res_dffe33_wo;
	wire  [7:0]  exp_res_dffe3_wi;
	wire  [7:0]  exp_res_dffe3_wo;
	wire  [7:0]  exp_res_dffe4_wi;
	wire  [7:0]  exp_res_dffe4_wo;
	wire  [7:0]  exp_res_max_w;
	wire  [8:0]  exp_res_not_zero_w;
	wire  [8:0]  exp_res_rounding_adder_dataa_w;
	wire  [8:0]  exp_res_rounding_adder_w;
	wire  exp_rounded_res_infinity_w;
	wire  [7:0]  exp_rounded_res_max_w;
	wire  [7:0]  exp_rounded_res_w;
	wire  [8:0]  exp_rounding_adjustment_w;
	wire  [8:0]  exp_value;
	wire  force_infinity_w;
	wire  force_nan_w;
	wire  force_zero_w;
	wire  guard_bit_dffe3_wo;
	wire  infinite_output_sign_dffe1_wi;
	wire  infinite_output_sign_dffe1_wo;
	wire  infinite_output_sign_dffe21_wi;
	wire  infinite_output_sign_dffe21_wo;
	wire  infinite_output_sign_dffe22_wi;
	wire  infinite_output_sign_dffe22_wo;
	wire  infinite_output_sign_dffe23_wi;
	wire  infinite_output_sign_dffe23_wo;
	wire  infinite_output_sign_dffe25_wi;
	wire  infinite_output_sign_dffe25_wo;
	wire  infinite_output_sign_dffe26_wi;
	wire  infinite_output_sign_dffe26_wo;
	wire  infinite_output_sign_dffe27_wi;
	wire  infinite_output_sign_dffe27_wo;
	wire  infinite_output_sign_dffe2_wi;
	wire  infinite_output_sign_dffe2_wo;
	wire  infinite_output_sign_dffe31_wi;
	wire  infinite_output_sign_dffe31_wo;
	wire  infinite_output_sign_dffe32_wi;
	wire  infinite_output_sign_dffe32_wo;
	wire  infinite_output_sign_dffe33_wi;
	wire  infinite_output_sign_dffe33_wo;
	wire  infinite_output_sign_dffe3_wi;
	wire  infinite_output_sign_dffe3_wo;
	wire  infinite_output_sign_dffe41_wi;
	wire  infinite_output_sign_dffe41_wo;
	wire  infinite_output_sign_dffe42_wi;
	wire  infinite_output_sign_dffe42_wo;
	wire  infinite_output_sign_dffe4_wi;
	wire  infinite_output_sign_dffe4_wo;
	wire  infinite_res_dff32_wi;
	wire  infinite_res_dff32_wo;
	wire  infinite_res_dff33_wi;
	wire  infinite_res_dff33_wo;
	wire  infinite_res_dffe3_wi;
	wire  infinite_res_dffe3_wo;
	wire  infinite_res_dffe41_wi;
	wire  infinite_res_dffe41_wo;
	wire  infinite_res_dffe42_wi;
	wire  infinite_res_dffe42_wo;
	wire  infinite_res_dffe4_wi;
	wire  infinite_res_dffe4_wo;
	wire  infinity_magnitude_sub_dffe21_wi;
	wire  infinity_magnitude_sub_dffe21_wo;
	wire  infinity_magnitude_sub_dffe22_wi;
	wire  infinity_magnitude_sub_dffe22_wo;
	wire  infinity_magnitude_sub_dffe23_wi;
	wire  infinity_magnitude_sub_dffe23_wo;
	wire  infinity_magnitude_sub_dffe26_wi;
	wire  infinity_magnitude_sub_dffe26_wo;
	wire  infinity_magnitude_sub_dffe27_wi;
	wire  infinity_magnitude_sub_dffe27_wo;
	wire  infinity_magnitude_sub_dffe2_wi;
	wire  infinity_magnitude_sub_dffe2_wo;
	wire  infinity_magnitude_sub_dffe31_wi;
	wire  infinity_magnitude_sub_dffe31_wo;
	wire  infinity_magnitude_sub_dffe32_wi;
	wire  infinity_magnitude_sub_dffe32_wo;
	wire  infinity_magnitude_sub_dffe33_wi;
	wire  infinity_magnitude_sub_dffe33_wo;
	wire  infinity_magnitude_sub_dffe3_wi;
	wire  infinity_magnitude_sub_dffe3_wo;
	wire  infinity_magnitude_sub_dffe41_wi;
	wire  infinity_magnitude_sub_dffe41_wo;
	wire  infinity_magnitude_sub_dffe42_wi;
	wire  infinity_magnitude_sub_dffe42_wo;
	wire  infinity_magnitude_sub_dffe4_wi;
	wire  infinity_magnitude_sub_dffe4_wo;
	wire  input_dataa_denormal_dffe11_wi;
	wire  input_dataa_denormal_dffe11_wo;
	wire  input_dataa_denormal_w;
	wire  input_dataa_infinite_dffe11_wi;
	wire  input_dataa_infinite_dffe11_wo;
	wire  input_dataa_infinite_dffe12_wi;
	wire  input_dataa_infinite_dffe12_wo;
	wire  input_dataa_infinite_dffe13_wi;
	wire  input_dataa_infinite_dffe13_wo;
	wire  input_dataa_infinite_dffe14_wi;
	wire  input_dataa_infinite_dffe14_wo;
	wire  input_dataa_infinite_dffe15_wi;
	wire  input_dataa_infinite_dffe15_wo;
	wire  input_dataa_infinite_w;
	wire  input_dataa_nan_dffe11_wi;
	wire  input_dataa_nan_dffe11_wo;
	wire  input_dataa_nan_dffe12_wi;
	wire  input_dataa_nan_dffe12_wo;
	wire  input_dataa_nan_w;
	wire  input_dataa_zero_dffe11_wi;
	wire  input_dataa_zero_dffe11_wo;
	wire  input_dataa_zero_w;
	wire  input_datab_denormal_dffe11_wi;
	wire  input_datab_denormal_dffe11_wo;
	wire  input_datab_denormal_w;
	wire  input_datab_infinite_dffe11_wi;
	wire  input_datab_infinite_dffe11_wo;
	wire  input_datab_infinite_dffe12_wi;
	wire  input_datab_infinite_dffe12_wo;
	wire  input_datab_infinite_dffe13_wi;
	wire  input_datab_infinite_dffe13_wo;
	wire  input_datab_infinite_dffe14_wi;
	wire  input_datab_infinite_dffe14_wo;
	wire  input_datab_infinite_dffe15_wi;
	wire  input_datab_infinite_dffe15_wo;
	wire  input_datab_infinite_w;
	wire  input_datab_nan_dffe11_wi;
	wire  input_datab_nan_dffe11_wo;
	wire  input_datab_nan_dffe12_wi;
	wire  input_datab_nan_dffe12_wo;
	wire  input_datab_nan_w;
	wire  input_datab_zero_dffe11_wi;
	wire  input_datab_zero_dffe11_wo;
	wire  input_datab_zero_w;
	wire  input_is_infinite_dffe1_wi;
	wire  input_is_infinite_dffe1_wo;
	wire  input_is_infinite_dffe21_wi;
	wire  input_is_infinite_dffe21_wo;
	wire  input_is_infinite_dffe22_wi;
	wire  input_is_infinite_dffe22_wo;
	wire  input_is_infinite_dffe23_wi;
	wire  input_is_infinite_dffe23_wo;
	wire  input_is_infinite_dffe25_wi;
	wire  input_is_infinite_dffe25_wo;
	wire  input_is_infinite_dffe26_wi;
	wire  input_is_infinite_dffe26_wo;
	wire  input_is_infinite_dffe27_wi;
	wire  input_is_infinite_dffe27_wo;
	wire  input_is_infinite_dffe2_wi;
	wire  input_is_infinite_dffe2_wo;
	wire  input_is_infinite_dffe31_wi;
	wire  input_is_infinite_dffe31_wo;
	wire  input_is_infinite_dffe32_wi;
	wire  input_is_infinite_dffe32_wo;
	wire  input_is_infinite_dffe33_wi;
	wire  input_is_infinite_dffe33_wo;
	wire  input_is_infinite_dffe3_wi;
	wire  input_is_infinite_dffe3_wo;
	wire  input_is_infinite_dffe41_wi;
	wire  input_is_infinite_dffe41_wo;
	wire  input_is_infinite_dffe42_wi;
	wire  input_is_infinite_dffe42_wo;
	wire  input_is_infinite_dffe4_wi;
	wire  input_is_infinite_dffe4_wo;
	wire  input_is_nan_dffe13_wi;
	wire  input_is_nan_dffe13_wo;
	wire  input_is_nan_dffe14_wi;
	wire  input_is_nan_dffe14_wo;
	wire  input_is_nan_dffe15_wi;
	wire  input_is_nan_dffe15_wo;
	wire  input_is_nan_dffe1_wi;
	wire  input_is_nan_dffe1_wo;
	wire  input_is_nan_dffe21_wi;
	wire  input_is_nan_dffe21_wo;
	wire  input_is_nan_dffe22_wi;
	wire  input_is_nan_dffe22_wo;
	wire  input_is_nan_dffe23_wi;
	wire  input_is_nan_dffe23_wo;
	wire  input_is_nan_dffe25_wi;
	wire  input_is_nan_dffe25_wo;
	wire  input_is_nan_dffe26_wi;
	wire  input_is_nan_dffe26_wo;
	wire  input_is_nan_dffe27_wi;
	wire  input_is_nan_dffe27_wo;
	wire  input_is_nan_dffe2_wi;
	wire  input_is_nan_dffe2_wo;
	wire  input_is_nan_dffe31_wi;
	wire  input_is_nan_dffe31_wo;
	wire  input_is_nan_dffe32_wi;
	wire  input_is_nan_dffe32_wo;
	wire  input_is_nan_dffe33_wi;
	wire  input_is_nan_dffe33_wo;
	wire  input_is_nan_dffe3_wi;
	wire  input_is_nan_dffe3_wo;
	wire  input_is_nan_dffe41_wi;
	wire  input_is_nan_dffe41_wo;
	wire  input_is_nan_dffe42_wi;
	wire  input_is_nan_dffe42_wo;
	wire  input_is_nan_dffe4_wi;
	wire  input_is_nan_dffe4_wo;
	wire  [27:0]  man_2comp_res_dataa_w;
	wire  [27:0]  man_2comp_res_datab_w;
	wire  [27:0]  man_2comp_res_w;
	wire  [22:0]  man_a_not_zero_w;
	wire  [27:0]  man_add_sub_dataa_w;
	wire  [27:0]  man_add_sub_datab_w;
	wire  [25:0]  man_add_sub_res_mag_dffe21_wi;
	wire  [25:0]  man_add_sub_res_mag_dffe21_wo;
	wire  [25:0]  man_add_sub_res_mag_dffe23_wi;
	wire  [25:0]  man_add_sub_res_mag_dffe23_wo;
	wire  [25:0]  man_add_sub_res_mag_dffe26_wi;
	wire  [25:0]  man_add_sub_res_mag_dffe26_wo;
	wire  [27:0]  man_add_sub_res_mag_dffe27_wi;
	wire  [27:0]  man_add_sub_res_mag_dffe27_wo;
	wire  [27:0]  man_add_sub_res_mag_w2;
	wire  man_add_sub_res_sign_dffe21_wo;
	wire  man_add_sub_res_sign_dffe23_wi;
	wire  man_add_sub_res_sign_dffe23_wo;
	wire  man_add_sub_res_sign_dffe26_wi;
	wire  man_add_sub_res_sign_dffe26_wo;
	wire  man_add_sub_res_sign_dffe27_wi;
	wire  man_add_sub_res_sign_dffe27_wo;
	wire  man_add_sub_res_sign_w2;
	wire  [27:0]  man_add_sub_w;
	wire  [22:0]  man_all_zeros_w;
	wire  [22:0]  man_b_not_zero_w;
	wire  [25:0]  man_dffe31_wo;
	wire  [25:0]  man_intermediate_res_w;
	wire  [4:0]  man_leading_zeros_cnt_w;
	wire  [4:0]  man_leading_zeros_dffe31_wi;
	wire  [4:0]  man_leading_zeros_dffe31_wo;
	wire  [22:0]  man_nan_w;
	wire  [22:0]  man_out_dffe5_wi;
	wire  [22:0]  man_out_dffe5_wo;
	wire  [22:0]  man_res_dffe4_wi;
	wire  [22:0]  man_res_dffe4_wo;
	wire  man_res_is_not_zero_dffe31_wi;
	wire  man_res_is_not_zero_dffe31_wo;
	wire  man_res_is_not_zero_dffe32_wi;
	wire  man_res_is_not_zero_dffe32_wo;
	wire  man_res_is_not_zero_dffe33_wi;
	wire  man_res_is_not_zero_dffe33_wo;
	wire  man_res_is_not_zero_dffe3_wi;
	wire  man_res_is_not_zero_dffe3_wo;
	wire  man_res_is_not_zero_dffe41_wi;
	wire  man_res_is_not_zero_dffe41_wo;
	wire  man_res_is_not_zero_dffe42_wi;
	wire  man_res_is_not_zero_dffe42_wo;
	wire  man_res_is_not_zero_dffe4_wi;
	wire  man_res_is_not_zero_dffe4_wo;
	wire  [25:0]  man_res_mag_w2;
	wire  man_res_not_zero_dffe23_wi;
	wire  man_res_not_zero_dffe23_wo;
	wire  man_res_not_zero_dffe26_wi;
	wire  man_res_not_zero_dffe26_wo;
	wire  [24:0]  man_res_not_zero_w2;
	wire  [25:0]  man_res_rounding_add_sub_datab_w;
	wire  [25:0]  man_res_rounding_add_sub_w;
	wire  [23:0]  man_res_w3;
	wire  [22:0]  man_rounded_res_w;
	wire  man_rounding_add_value_w;
	wire  [23:0]  man_smaller_dffe13_wi;
	wire  [23:0]  man_smaller_dffe13_wo;
	wire  [23:0]  man_smaller_w;
	wire  need_complement_dffe22_wi;
	wire  need_complement_dffe22_wo;
	wire  need_complement_dffe2_wi;
	wire  need_complement_dffe2_wo;
	wire  [1:0]  pos_sign_bit_ext;
	wire  [3:0]  priority_encoder_1pads_w;
	wire  round_bit_dffe21_wi;
	wire  round_bit_dffe21_wo;
	wire  round_bit_dffe23_wi;
	wire  round_bit_dffe23_wo;
	wire  round_bit_dffe26_wi;
	wire  round_bit_dffe26_wo;
	wire  round_bit_dffe31_wi;
	wire  round_bit_dffe31_wo;
	wire  round_bit_dffe32_wi;
	wire  round_bit_dffe32_wo;
	wire  round_bit_dffe33_wi;
	wire  round_bit_dffe33_wo;
	wire  round_bit_dffe3_wi;
	wire  round_bit_dffe3_wo;
	wire  round_bit_w;
	wire  rounded_res_infinity_dffe4_wi;
	wire  rounded_res_infinity_dffe4_wo;
	wire  [4:0]  rshift_distance_dffe13_wi;
	wire  [4:0]  rshift_distance_dffe13_wo;
	wire  [4:0]  rshift_distance_dffe14_wi;
	wire  [4:0]  rshift_distance_dffe14_wo;
	wire  [4:0]  rshift_distance_dffe15_wi;
	wire  [4:0]  rshift_distance_dffe15_wo;
	wire  [4:0]  rshift_distance_w;
	wire  sign_dffe31_wi;
	wire  sign_dffe31_wo;
	wire  sign_dffe32_wi;
	wire  sign_dffe32_wo;
	wire  sign_dffe33_wi;
	wire  sign_dffe33_wo;
	wire  sign_out_dffe5_wi;
	wire  sign_out_dffe5_wo;
	wire  sign_res_dffe3_wi;
	wire  sign_res_dffe3_wo;
	wire  sign_res_dffe41_wi;
	wire  sign_res_dffe41_wo;
	wire  sign_res_dffe42_wi;
	wire  sign_res_dffe42_wo;
	wire  sign_res_dffe4_wi;
	wire  sign_res_dffe4_wo;
	wire  [5:0]  sticky_bit_cnt_dataa_w;
	wire  [5:0]  sticky_bit_cnt_datab_w;
	wire  [5:0]  sticky_bit_cnt_res_w;
	wire  sticky_bit_dffe1_wi;
	wire  sticky_bit_dffe1_wo;
	wire  sticky_bit_dffe21_wi;
	wire  sticky_bit_dffe21_wo;
	wire  sticky_bit_dffe22_wi;
	wire  sticky_bit_dffe22_wo;
	wire  sticky_bit_dffe23_wi;
	wire  sticky_bit_dffe23_wo;
	wire  sticky_bit_dffe25_wi;
	wire  sticky_bit_dffe25_wo;
	wire  sticky_bit_dffe26_wi;
	wire  sticky_bit_dffe26_wo;
	wire  sticky_bit_dffe27_wi;
	wire  sticky_bit_dffe27_wo;
	wire  sticky_bit_dffe2_wi;
	wire  sticky_bit_dffe2_wo;
	wire  sticky_bit_dffe31_wi;
	wire  sticky_bit_dffe31_wo;
	wire  sticky_bit_dffe32_wi;
	wire  sticky_bit_dffe32_wo;
	wire  sticky_bit_dffe33_wi;
	wire  sticky_bit_dffe33_wo;
	wire  sticky_bit_dffe3_wi;
	wire  sticky_bit_dffe3_wo;
	wire  sticky_bit_w;
	wire  [5:0]  trailing_zeros_limit_w;
	wire  zero_man_sign_dffe21_wi;
	wire  zero_man_sign_dffe21_wo;
	wire  zero_man_sign_dffe22_wi;
	wire  zero_man_sign_dffe22_wo;
	wire  zero_man_sign_dffe23_wi;
	wire  zero_man_sign_dffe23_wo;
	wire  zero_man_sign_dffe26_wi;
	wire  zero_man_sign_dffe26_wo;
	wire  zero_man_sign_dffe27_wi;
	wire  zero_man_sign_dffe27_wo;
	wire  zero_man_sign_dffe2_wi;
	wire  zero_man_sign_dffe2_wo;
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
