osafune/ulexite/de0_sample/cineraria_ulexite/software/ulexite_bmpload_bsp/system.h

/*
 * system.h - SOPC Builder system and BSP software package information
 *
 * Machine generated for CPU 'nios2_fast' in SOPC Builder design 'cineraria_core'
 * SOPC Builder design path: C:/PROJECT/c85_ulexite/fpga/cineraria_ulexite/cineraria_core.sopcinfo
 *
 * Generated: Tue Oct 15 04:30:56 JST 2013
 */

/*
 * DO NOT MODIFY THIS FILE
 *
 * Changing this file will have subtle consequences
 * which will almost certainly lead to a nonfunctioning
 * system. If you do modify this file, be aware that your
 * changes will be overwritten and lost when this file
 * is generated again.
 *
 * DO NOT MODIFY THIS FILE
 */

/*
 * License Agreement
 *
 * Copyright (c) 2008
 * Altera Corporation, San Jose, California, USA.
 * All rights reserved.
 *
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
 * This agreement shall be governed in all respects by the laws of the State
 * of California and by the laws of the United States of America.
 */

#ifndef __SYSTEM_H_
#define __SYSTEM_H_

/* Include definitions from linker script generator */
#include "linker.h"


/*
 * CPU configuration
 *
 */

#define ALT_CPU_ARCHITECTURE "altera_nios2_qsys"
#define ALT_CPU_BIG_ENDIAN 0
#define ALT_CPU_BREAK_ADDR 0xfff0820
#define ALT_CPU_CPU_FREQ 100000000u
#define ALT_CPU_CPU_ID_SIZE 1
#define ALT_CPU_CPU_ID_VALUE 0x00000000
#define ALT_CPU_CPU_IMPLEMENTATION "fast"
#define ALT_CPU_DATA_ADDR_WIDTH 0x1d
#define ALT_CPU_DCACHE_LINE_SIZE 32
#define ALT_CPU_DCACHE_LINE_SIZE_LOG2 5
#define ALT_CPU_DCACHE_SIZE 8192
#define ALT_CPU_EXCEPTION_ADDR 0x20
#define ALT_CPU_FLUSHDA_SUPPORTED
#define ALT_CPU_FREQ 100000000
#define ALT_CPU_HARDWARE_DIVIDE_PRESENT 1
#define ALT_CPU_HARDWARE_MULTIPLY_PRESENT 1
#define ALT_CPU_HARDWARE_MULX_PRESENT 0
#define ALT_CPU_HAS_DEBUG_CORE 1
#define ALT_CPU_HAS_DEBUG_STUB
#define ALT_CPU_HAS_JMPI_INSTRUCTION
#define ALT_CPU_ICACHE_LINE_SIZE 32
#define ALT_CPU_ICACHE_LINE_SIZE_LOG2 5
#define ALT_CPU_ICACHE_SIZE 8192
#define ALT_CPU_INITDA_SUPPORTED
#define ALT_CPU_INST_ADDR_WIDTH 0x1c
#define ALT_CPU_NAME "nios2_fast"
#define ALT_CPU_NUM_OF_SHADOW_REG_SETS 0
#define ALT_CPU_RESET_ADDR 0xf000000


/*
 * CPU configuration (with legacy prefix - don't use these anymore)
 *
 */

#define NIOS2_BIG_ENDIAN 0
#define NIOS2_BREAK_ADDR 0xfff0820
#define NIOS2_CPU_FREQ 100000000u
#define NIOS2_CPU_ID_SIZE 1
#define NIOS2_CPU_ID_VALUE 0x00000000
#define NIOS2_CPU_IMPLEMENTATION "fast"
#define NIOS2_DATA_ADDR_WIDTH 0x1d
#define NIOS2_DCACHE_LINE_SIZE 32
#define NIOS2_DCACHE_LINE_SIZE_LOG2 5
#define NIOS2_DCACHE_SIZE 8192
#define NIOS2_EXCEPTION_ADDR 0x20
#define NIOS2_FLUSHDA_SUPPORTED
#define NIOS2_HARDWARE_DIVIDE_PRESENT 1
#define NIOS2_HARDWARE_MULTIPLY_PRESENT 1
#define NIOS2_HARDWARE_MULX_PRESENT 0
#define NIOS2_HAS_DEBUG_CORE 1
#define NIOS2_HAS_DEBUG_STUB
#define NIOS2_HAS_JMPI_INSTRUCTION
#define NIOS2_ICACHE_LINE_SIZE 32
#define NIOS2_ICACHE_LINE_SIZE_LOG2 5
#define NIOS2_ICACHE_SIZE 8192
#define NIOS2_INITDA_SUPPORTED
#define NIOS2_INST_ADDR_WIDTH 0x1c
#define NIOS2_NUM_OF_SHADOW_REG_SETS 0
#define NIOS2_RESET_ADDR 0xf000000


/*
 * Custom instruction macros
 *
 */

#define ALT_CI_FPOINT(n,A,B) __builtin_custom_inii(ALT_CI_FPOINT_N+(n&ALT_CI_FPOINT_N_MASK),(A),(B))
#define ALT_CI_FPOINT_N 0xfc
#define ALT_CI_FPOINT_N_MASK ((1<<2)-1)
#define ALT_CI_PIXELSIMD(n,A,B) __builtin_custom_inii(ALT_CI_PIXELSIMD_N+(n&ALT_CI_PIXELSIMD_N_MASK),(A),(B))
#define ALT_CI_PIXELSIMD_N 0x0
#define ALT_CI_PIXELSIMD_N_MASK ((1<<3)-1)


/*
 * Define for each module class mastered by the CPU
 *
 */

#define __ALTERA_AVALON_JTAG_UART
#define __ALTERA_AVALON_NEW_SDRAM_CONTROLLER
#define __ALTERA_AVALON_ONCHIP_MEMORY2
#define __ALTERA_AVALON_PIO
#define __ALTERA_AVALON_SYSID_QSYS
#define __ALTERA_AVALON_TIMER
#define __ALTERA_AVALON_UART
#define __ALTERA_NIOS2_QSYS
#define __ALTERA_NIOS_CUSTOM_INSTR_FLOATING_POINT
#define __AVALONIF_SPU
#define __BACKLIGHT_CONTROLLER
#define __MMCDMA
#define __PIXELSIMD
#define __PS2_COMPONENT
#define __VGA_COMPONENT


/*
 * System configuration
 *
 */

#define ALT_DEVICE_FAMILY "Cyclone III"
#define ALT_ENHANCED_INTERRUPT_API_PRESENT
#define ALT_IRQ_BASE NULL
#define ALT_LOG_PORT "/dev/null"
#define ALT_LOG_PORT_BASE 0x0
#define ALT_LOG_PORT_DEV null
#define ALT_LOG_PORT_TYPE ""
#define ALT_NUM_EXTERNAL_INTERRUPT_CONTROLLERS 0
#define ALT_NUM_INTERNAL_INTERRUPT_CONTROLLERS 1
#define ALT_NUM_INTERRUPT_CONTROLLERS 1
#define ALT_STDERR "/dev/jtag_uart"
#define ALT_STDERR_BASE 0x10000080
#define ALT_STDERR_DEV jtag_uart
#define ALT_STDERR_IS_JTAG_UART
#define ALT_STDERR_PRESENT
#define ALT_STDERR_TYPE "altera_avalon_jtag_uart"
#define ALT_STDIN "/dev/jtag_uart"
#define ALT_STDIN_BASE 0x10000080
#define ALT_STDIN_DEV jtag_uart
#define ALT_STDIN_IS_JTAG_UART
#define ALT_STDIN_PRESENT
#define ALT_STDIN_TYPE "altera_avalon_jtag_uart"
#define ALT_STDOUT "/dev/jtag_uart"
#define ALT_STDOUT_BASE 0x10000080
#define ALT_STDOUT_DEV jtag_uart
#define ALT_STDOUT_IS_JTAG_UART
#define ALT_STDOUT_PRESENT
#define ALT_STDOUT_TYPE "altera_avalon_jtag_uart"
#define ALT_SYSTEM_NAME "cineraria_core"


/*
 * blcon configuration
 *
 */

#define ALT_MODULE_CLASS_blcon backlight_controller
#define BLCON_BASE 0x10000820
#define BLCON_IRQ -1
#define BLCON_IRQ_INTERRUPT_CONTROLLER_ID -1
#define BLCON_NAME "/dev/blcon"
#define BLCON_SPAN 4
#define BLCON_TYPE "backlight_controller"


/*
 * dipsw configuration
 *
 */

#define ALT_MODULE_CLASS_dipsw altera_avalon_pio
#define DIPSW_BASE 0x10000260
#define DIPSW_BIT_CLEARING_EDGE_REGISTER 0
#define DIPSW_BIT_MODIFYING_OUTPUT_REGISTER 0
#define DIPSW_CAPTURE 0
#define DIPSW_DATA_WIDTH 10
#define DIPSW_DO_TEST_BENCH_WIRING 0
#define DIPSW_DRIVEN_SIM_VALUE 0
#define DIPSW_EDGE_TYPE "NONE"
#define DIPSW_FREQ 40000000
#define DIPSW_HAS_IN 1
#define DIPSW_HAS_OUT 0
#define DIPSW_HAS_TRI 0
#define DIPSW_IRQ -1
#define DIPSW_IRQ_INTERRUPT_CONTROLLER_ID -1
#define DIPSW_IRQ_TYPE "NONE"
#define DIPSW_NAME "/dev/dipsw"
#define DIPSW_RESET_VALUE 0
#define DIPSW_SPAN 16
#define DIPSW_TYPE "altera_avalon_pio"


/*
 * gpio1 configuration
 *
 */

#define ALT_MODULE_CLASS_gpio1 altera_avalon_pio
#define GPIO1_BASE 0x100002a0
#define GPIO1_BIT_CLEARING_EDGE_REGISTER 0
#define GPIO1_BIT_MODIFYING_OUTPUT_REGISTER 0
#define GPIO1_CAPTURE 0
#define GPIO1_DATA_WIDTH 32
#define GPIO1_DO_TEST_BENCH_WIRING 0
#define GPIO1_DRIVEN_SIM_VALUE 0
#define GPIO1_EDGE_TYPE "NONE"
#define GPIO1_FREQ 40000000
#define GPIO1_HAS_IN 0
#define GPIO1_HAS_OUT 0
#define GPIO1_HAS_TRI 1
#define GPIO1_IRQ -1
#define GPIO1_IRQ_INTERRUPT_CONTROLLER_ID -1
#define GPIO1_IRQ_TYPE "NONE"
#define GPIO1_NAME "/dev/gpio1"
#define GPIO1_RESET_VALUE 0
#define GPIO1_SPAN 16
#define GPIO1_TYPE "altera_avalon_pio"


/*
 * hal configuration
 *
 */

#define ALT_MAX_FD 32
#define ALT_SYS_CLK SYSTIMER
#define ALT_TIMESTAMP_CLK none


/*
 * ipl_memory configuration
 *
 */

#define ALT_MODULE_CLASS_ipl_memory altera_avalon_onchip_memory2
#define IPL_MEMORY_ALLOW_IN_SYSTEM_MEMORY_CONTENT_EDITOR 0
#define IPL_MEMORY_ALLOW_MRAM_SIM_CONTENTS_ONLY_FILE 0
#define IPL_MEMORY_BASE 0xf000000
#define IPL_MEMORY_CONTENTS_INFO ""
#define IPL_MEMORY_DUAL_PORT 0
#define IPL_MEMORY_GUI_RAM_BLOCK_TYPE "AUTO"
#define IPL_MEMORY_INIT_CONTENTS_FILE "ipl_memory_elfboot"
#define IPL_MEMORY_INIT_MEM_CONTENT 1
#define IPL_MEMORY_INSTANCE_ID "BROM"
#define IPL_MEMORY_IRQ -1
#define IPL_MEMORY_IRQ_INTERRUPT_CONTROLLER_ID -1
#define IPL_MEMORY_NAME "/dev/ipl_memory"
#define IPL_MEMORY_NON_DEFAULT_INIT_FILE_ENABLED 1
#define IPL_MEMORY_RAM_BLOCK_TYPE "AUTO"
#define IPL_MEMORY_READ_DURING_WRITE_MODE "DONT_CARE"
#define IPL_MEMORY_SINGLE_CLOCK_OP 0
#define IPL_MEMORY_SIZE_MULTIPLE 1
#define IPL_MEMORY_SIZE_VALUE 8192
#define IPL_MEMORY_SPAN 8192
#define IPL_MEMORY_TYPE "altera_avalon_onchip_memory2"
#define IPL_MEMORY_WRITABLE 1


/*
 * jtag_uart configuration
 *
 */

#define ALT_MODULE_CLASS_jtag_uart altera_avalon_jtag_uart
#define JTAG_UART_BASE 0x10000080
#define JTAG_UART_IRQ 10
#define JTAG_UART_IRQ_INTERRUPT_CONTROLLER_ID 0
#define JTAG_UART_NAME "/dev/jtag_uart"
#define JTAG_UART_READ_DEPTH 64
#define JTAG_UART_READ_THRESHOLD 8
#define JTAG_UART_SPAN 8
#define JTAG_UART_TYPE "altera_avalon_jtag_uart"
#define JTAG_UART_WRITE_DEPTH 64
#define JTAG_UART_WRITE_THRESHOLD 8


/*
 * led configuration
 *
 */

#define ALT_MODULE_CLASS_led altera_avalon_pio
#define LED_BASE 0x10000200
#define LED_BIT_CLEARING_EDGE_REGISTER 0
#define LED_BIT_MODIFYING_OUTPUT_REGISTER 0
#define LED_CAPTURE 0
#define LED_DATA_WIDTH 10
#define LED_DO_TEST_BENCH_WIRING 0
#define LED_DRIVEN_SIM_VALUE 0
#define LED_EDGE_TYPE "NONE"
#define LED_FREQ 40000000
#define LED_HAS_IN 0
#define LED_HAS_OUT 1
#define LED_HAS_TRI 0
#define LED_IRQ -1
#define LED_IRQ_INTERRUPT_CONTROLLER_ID -1
#define LED_IRQ_TYPE "NONE"
#define LED_NAME "/dev/led"
#define LED_RESET_VALUE 0
#define LED_SPAN 16
#define LED_TYPE "altera_avalon_pio"


/*
 * led_7seg configuration
 *
 */

#define ALT_MODULE_CLASS_led_7seg altera_avalon_pio
#define LED_7SEG_BASE 0x10000220
#define LED_7SEG_BIT_CLEARING_EDGE_REGISTER 0
#define LED_7SEG_BIT_MODIFYING_OUTPUT_REGISTER 0
#define LED_7SEG_CAPTURE 0
#define LED_7SEG_DATA_WIDTH 32
#define LED_7SEG_DO_TEST_BENCH_WIRING 0
#define LED_7SEG_DRIVEN_SIM_VALUE 0
#define LED_7SEG_EDGE_TYPE "NONE"
#define LED_7SEG_FREQ 40000000
#define LED_7SEG_HAS_IN 0
#define LED_7SEG_HAS_OUT 1
#define LED_7SEG_HAS_TRI 0
#define LED_7SEG_IRQ -1
#define LED_7SEG_IRQ_INTERRUPT_CONTROLLER_ID -1
#define LED_7SEG_IRQ_TYPE "NONE"
#define LED_7SEG_NAME "/dev/led_7seg"
#define LED_7SEG_RESET_VALUE 0
#define LED_7SEG_SPAN 16
#define LED_7SEG_TYPE "altera_avalon_pio"


/*
 * mmcdma configuration
 *
 */

#define ALT_MODULE_CLASS_mmcdma mmcdma
#define MMCDMA_BASE 0x10000400
#define MMCDMA_IRQ 6
#define MMCDMA_IRQ_INTERRUPT_CONTROLLER_ID 0
#define MMCDMA_NAME "/dev/mmcdma"
#define MMCDMA_SPAN 1024
#define MMCDMA_TYPE "mmcdma"


/*
 * ps2_keyboard configuration
 *
 */

#define ALT_MODULE_CLASS_ps2_keyboard ps2_component
#define PS2_KEYBOARD_BASE 0x10000300
#define PS2_KEYBOARD_IRQ 12
#define PS2_KEYBOARD_IRQ_INTERRUPT_CONTROLLER_ID 0
#define PS2_KEYBOARD_NAME "/dev/ps2_keyboard"
#define PS2_KEYBOARD_SPAN 8
#define PS2_KEYBOARD_TYPE "ps2_component"


/*
 * psw configuration
 *
 */

#define ALT_MODULE_CLASS_psw altera_avalon_pio
#define PSW_BASE 0x10000240
#define PSW_BIT_CLEARING_EDGE_REGISTER 0
#define PSW_BIT_MODIFYING_OUTPUT_REGISTER 0
#define PSW_CAPTURE 1
#define PSW_DATA_WIDTH 3
#define PSW_DO_TEST_BENCH_WIRING 0
#define PSW_DRIVEN_SIM_VALUE 0
#define PSW_EDGE_TYPE "FALLING"
#define PSW_FREQ 40000000
#define PSW_HAS_IN 1
#define PSW_HAS_OUT 0
#define PSW_HAS_TRI 0
#define PSW_IRQ 14
#define PSW_IRQ_INTERRUPT_CONTROLLER_ID 0
#define PSW_IRQ_TYPE "EDGE"
#define PSW_NAME "/dev/psw"
#define PSW_RESET_VALUE 0
#define PSW_SPAN 16
#define PSW_TYPE "altera_avalon_pio"


/*
 * sdram configuration
 *
 */

#define ALT_MODULE_CLASS_sdram altera_avalon_new_sdram_controller
#define SDRAM_BASE 0x0
#define SDRAM_CAS_LATENCY 2
#define SDRAM_CONTENTS_INFO
#define SDRAM_INIT_NOP_DELAY 0.0
#define SDRAM_INIT_REFRESH_COMMANDS 2
#define SDRAM_IRQ -1
#define SDRAM_IRQ_INTERRUPT_CONTROLLER_ID -1
#define SDRAM_IS_INITIALIZED 1
#define SDRAM_NAME "/dev/sdram"
#define SDRAM_POWERUP_DELAY 200.0
#define SDRAM_REFRESH_PERIOD 15.625
#define SDRAM_REGISTER_DATA_IN 1
#define SDRAM_SDRAM_ADDR_WIDTH 0x16
#define SDRAM_SDRAM_BANK_WIDTH 2
#define SDRAM_SDRAM_COL_WIDTH 8
#define SDRAM_SDRAM_DATA_WIDTH 16
#define SDRAM_SDRAM_NUM_BANKS 4
#define SDRAM_SDRAM_NUM_CHIPSELECTS 1
#define SDRAM_SDRAM_ROW_WIDTH 12
#define SDRAM_SHARED_DATA 0
#define SDRAM_SIM_MODEL_BASE 0
#define SDRAM_SPAN 8388608
#define SDRAM_STARVATION_INDICATOR 0
#define SDRAM_TRISTATE_BRIDGE_SLAVE ""
#define SDRAM_TYPE "altera_avalon_new_sdram_controller"
#define SDRAM_T_AC 5.4
#define SDRAM_T_MRD 3
#define SDRAM_T_RCD 18.0
#define SDRAM_T_RFC 60.0
#define SDRAM_T_RP 18.0
#define SDRAM_T_WR 14.0


/*
 * spu configuration
 *
 */

#define ALT_MODULE_CLASS_spu avalonif_spu
#define SPU_BASE 0x10001000
#define SPU_IRQ 7
#define SPU_IRQ_INTERRUPT_CONTROLLER_ID 0
#define SPU_NAME "/dev/spu"
#define SPU_SPAN 2048
#define SPU_TYPE "avalonif_spu"


/*
 * sysid configuration
 *
 */

#define ALT_MODULE_CLASS_sysid altera_avalon_sysid_qsys
#define SYSID_BASE 0x10000000
#define SYSID_ID 538117937
#define SYSID_IRQ -1
#define SYSID_IRQ_INTERRUPT_CONTROLLER_ID -1
#define SYSID_NAME "/dev/sysid"
#define SYSID_SPAN 8
#define SYSID_TIMESTAMP 1381778683
#define SYSID_TYPE "altera_avalon_sysid_qsys"


/*
 * systimer configuration
 *
 */

#define ALT_MODULE_CLASS_systimer altera_avalon_timer
#define SYSTIMER_ALWAYS_RUN 0
#define SYSTIMER_BASE 0x10000020
#define SYSTIMER_COUNTER_SIZE 32
#define SYSTIMER_FIXED_PERIOD 0
#define SYSTIMER_FREQ 40000000
#define SYSTIMER_IRQ 0
#define SYSTIMER_IRQ_INTERRUPT_CONTROLLER_ID 0
#define SYSTIMER_LOAD_VALUE 39999
#define SYSTIMER_MULT 0.0010
#define SYSTIMER_NAME "/dev/systimer"
#define SYSTIMER_PERIOD 1
#define SYSTIMER_PERIOD_UNITS "ms"
#define SYSTIMER_RESET_OUTPUT 0
#define SYSTIMER_SNAPSHOT 1
#define SYSTIMER_SPAN 32
#define SYSTIMER_TICKS_PER_SEC 1000.0
#define SYSTIMER_TIMEOUT_PULSE_OUTPUT 0
#define SYSTIMER_TYPE "altera_avalon_timer"


/*
 * sysuart configuration
 *
 */

#define ALT_MODULE_CLASS_sysuart altera_avalon_uart
#define SYSUART_BASE 0x10000040
#define SYSUART_BAUD 115200
#define SYSUART_DATA_BITS 8
#define SYSUART_FIXED_BAUD 0
#define SYSUART_FREQ 40000000
#define SYSUART_IRQ 8
#define SYSUART_IRQ_INTERRUPT_CONTROLLER_ID 0
#define SYSUART_NAME "/dev/sysuart"
#define SYSUART_PARITY 'N'
#define SYSUART_SIM_CHAR_STREAM ""
#define SYSUART_SIM_TRUE_BAUD 0
#define SYSUART_SPAN 32
#define SYSUART_STOP_BITS 1
#define SYSUART_SYNC_REG_DEPTH 2
#define SYSUART_TYPE "altera_avalon_uart"
#define SYSUART_USE_CTS_RTS 1
#define SYSUART_USE_EOP_REGISTER 0


/*
 * vga configuration
 *
 */

#define ALT_MODULE_CLASS_vga vga_component
#define VGA_BASE 0x10000800
#define VGA_IRQ 4
#define VGA_IRQ_INTERRUPT_CONTROLLER_ID 0
#define VGA_NAME "/dev/vga"
#define VGA_SPAN 16
#define VGA_TYPE "vga_component"

#endif /* __SYSTEM_H_ */
