osafune/ulexite/de0_sample/cineraria_ulexite/cineraria_core/synthesis/submodules/altera_merlin_slave_agent.sv

// (C) 2001-2013 Altera Corporation. All rights reserved.
// Your use of Altera Corporation's design tools, logic functions and other 
// software and tools, and its AMPP partner logic functions, and any output 
// files any of the foregoing (including device programming or simulation 
// files), and any associated documentation or information are expressly subject 
// to the terms and conditions of the Altera Program License Subscription 
// Agreement, Altera MegaCore Function License Agreement, or other applicable 
// license agreement, including, without limitation, that your use is for the 
// sole purpose of programming logic devices manufactured by Altera and sold by 
// Altera or its authorized distributors.  Please refer to the applicable 
// agreement for further details.


// (C) 2001-2011 Altera Corporation. All rights reserved.
// Your use of Altera Corporation's design tools, logic functions and other 
// software and tools, and its AMPP partner logic functions, and any output 
// files any of the foregoing (including device programming or simulation 
// files), and any associated documentation or information are expressly subject 
// to the terms and conditions of the Altera Program License Subscription 
// Agreement, Altera MegaCore Function License Agreement, or other applicable 
// license agreement, including, without limitation, that your use is for the 
// sole purpose of programming logic devices manufactured by Altera and sold by 
// Altera or its authorized distributors.  Please refer to the applicable 
// agreement for further details.


// $Id: //acds/rel/13.0sp1/ip/merlin/altera_merlin_slave_agent/altera_merlin_slave_agent.sv#1 $
// $Revision: #1 $
// $Date: 2013/03/07 $
// $Author: swbranch $

`timescale 1 ns / 1 ns

module altera_merlin_slave_agent
#(
    // Packet parameters
    parameter PKT_BEGIN_BURST  = 81,
    parameter PKT_DATA_H       = 31,
    parameter PKT_DATA_L       = 0,
    parameter PKT_SYMBOL_W     = 8,
    parameter PKT_BYTEEN_H     = 71,
    parameter PKT_BYTEEN_L     = 68,
    parameter PKT_ADDR_H       = 63,
    parameter PKT_ADDR_L       = 32,
    parameter PKT_TRANS_LOCK   = 87,
    parameter PKT_TRANS_COMPRESSED_READ = 67,
    parameter PKT_TRANS_POSTED = 66, 
    parameter PKT_TRANS_WRITE  = 65,
    parameter PKT_TRANS_READ   = 64,
    parameter PKT_SRC_ID_H     = 74,
    parameter PKT_SRC_ID_L     = 72,
    parameter PKT_DEST_ID_H    = 77,
    parameter PKT_DEST_ID_L    = 75,
    parameter PKT_BURSTWRAP_H  = 85,
    parameter PKT_BURSTWRAP_L  = 82,
    parameter PKT_BYTE_CNT_H   = 81,
    parameter PKT_BYTE_CNT_L   = 78,
    parameter PKT_PROTECTION_H = 86,
    parameter PKT_PROTECTION_L = 86,
    parameter PKT_RESPONSE_STATUS_H = 89,
    parameter PKT_RESPONSE_STATUS_L = 88,
    parameter PKT_BURST_SIZE_H = 92,
    parameter PKT_BURST_SIZE_L = 90,
    parameter ST_DATA_W        = 93,
    parameter ST_CHANNEL_W     = 32,

    // Slave parameters
    parameter ADDR_W           = PKT_ADDR_H - PKT_ADDR_L + 1,
    parameter AVS_DATA_W       = PKT_DATA_H - PKT_DATA_L + 1,
    parameter AVS_BURSTCOUNT_W = 4,
    parameter PKT_SYMBOLS      = AVS_DATA_W / PKT_SYMBOL_W,
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
