osafune/ulexite/(commit log)

2013-12-19 v1.0 Rerelase
    [ulexite_panel.dxf, ulexite_pcb.pcb, vga_syncgen.smp_dump.txt]
2013-12-20 ファイル修正
    [vga_syncgen.smp_dump.txt]
2013-12-25 実装説明書追加
