osafune/ulexite/(notices)

Notices in the files:
de0_sample/cineraria_ulexite/cineraria_core/synthesis/submodules/fpoint_hw_qsys.v:
Legal Notice: (C)2010 Altera Corporation. All rights reserved. Your
